jesusalbertomoraleslopez-byte/control-dimensional-calidad/sku_guide.png

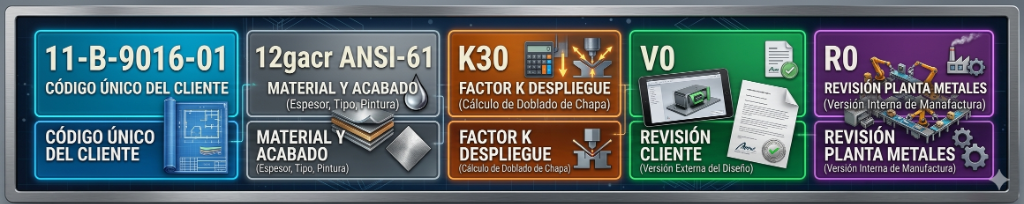
sku_guide.png
