jesusalbertomoraleslopez-byte/control-dimensional-calidad/README.md

# SIGRAMA METALES — Sistema Integral de Control Dimensional y Calidad 4.0

Sistema web industrial para gestión de calidad, diseño de ingeniería, control estadístico de procesos (SPC), inspección dimensional y visualización CAD 3D de piezas metálicas.

---

## 🚀 Versión: Mejoras de Visualización Septiembre 2026

Esta versión incorpora una renovación integral de la experiencia visual y operativa de la plataforma:

### 1. Centro de Control Principal (Cockpit 4.0)
- **Navegación Unificada:** Panel centralizado en 3 columnas ergonómicas (Pieza y Visor 3D | Opciones de Registro | Descargas).
- **Buscador en Tiempo Real:** Permite escribir y buscar cualquier número de pieza, SKU o consecutivo con auto-filtrado dinámico e inmediato.
- **Navegación Guiada:** Botones `◀ Ant.` y `Sig. ▶` que respetan los filtros de búsqueda activos.
- **Acceso Rápido Universal:** Botón de retorno "🔙 Volver a Página Principal" presente en todos los submódulos.

### 2. Visor CAD 3D Industrial
- **Pantalla Completa Optimizada:** Modo inmersivo para visualización e inspección de modelos 3D (STEP / CAD).
- **Barra de Herramientas Estilo SolidWorks / AutoCAD:** Botones con iconografía estándar para vistas ortogonales (Isométrica, Frontal, Superior, Lateral) y zoom fit.
- **Fondo Corporativo SIGRAMA:** Fondo integrado de alta fidelidad para el entorno 3D.
- **Captura al Portapapeles:** Botón directo para copiar la captura de pantalla extendida del visor 3D al portapapeles.

### 3. Centro de Descargas y Registro
- **Paquete Técnico Completo ZIP:** Compendio con planos de control, desplegados CNC (DXF), modelos 3D (STEP) y ficha técnica oficial autogenerada en PDF.
- **Historiales de Fabricación y Dimensionales:** Descarga directa de reportes y hojas de inspección.
- **Enlaces a Procesos Clave:** Acceso directo a PPVA (Aprobación de Planos), Primeras Piezas e Inspección en Piso (Órdenes de Fabricación).

---

## 🛠️ Tecnologías
- **Framework Web:** Streamlit
- **Motor 3D:** Three.js / OpenCascade (occt-import-js)
- **Almacenamiento Cloud:** Google Cloud Storage (GCS)
- **Base de Datos:** SQLite / JSON Seeds sincronizados
- **Generación de Reportes:** ReportLab (PDF), OpenPyXL, Python-docx

---
*Industria Sigrama S.A. de C.V. — Ingeniería que da resultados.*
