jesusalbertomoraleslopez-byte/control-dimensional-calidad/scratch/temp_design.xlsx

Sheet: CORTE
No. | RESP | DIM | LIM.I | LIM.S
1 | LASER | 19 | 18.985 | 19.015
2 | LASER | 3.527 | 3.512 | 3.542

Sheet: DOBLEZ
MEDIDA | DIMENSION | LIM.I | LIM.S
A | 0.63 | 0.615 | 0.645
B | 1.25 | 1.235 | 1.265
