jesusalbertomoraleslopez-byte/control-dimensional-calidad/sigrama_cad_bg.jpg

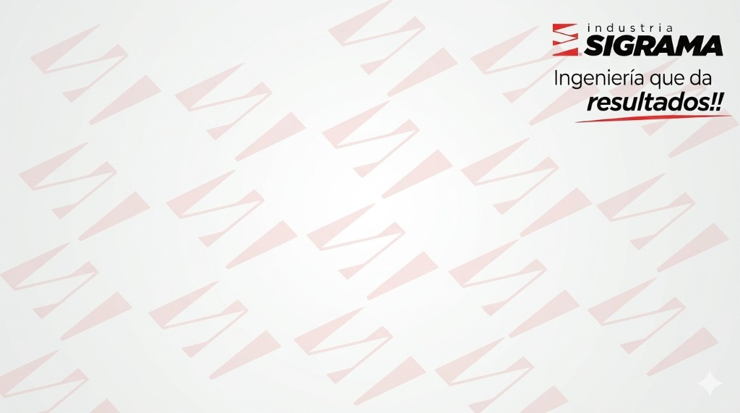
sigrama_cad_bg.jpg
