jesusalbertomoraleslopez-byte/control-dimensional-calidad/src/Proyectos/11-6463-01/Rev_R0/FactorK_61/Espesor_0.105/11-6463-01-(12gacr ANSI-61) - K61 - V6-R0.STEP

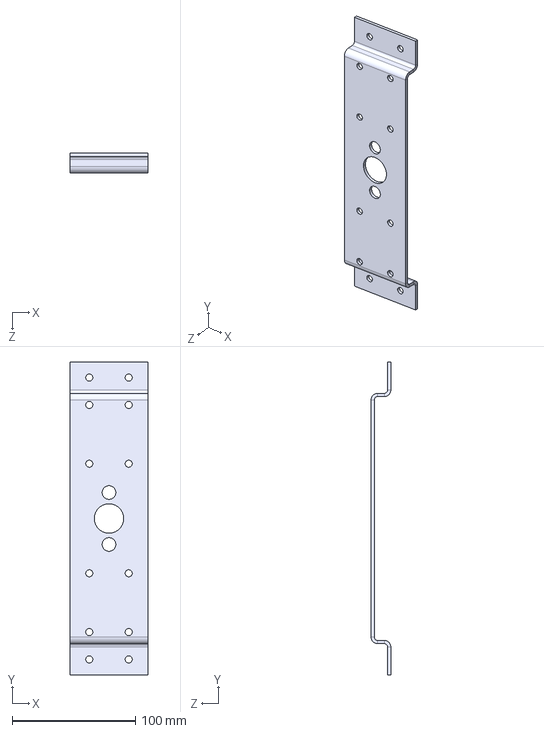
[picture p3: CAD file, 2026-09-10, last stored version]
src/Proyectos/11-6463-01/Rev_R0/FactorK_61/Espesor_0.105/11-6463-01-(12gacr ANSI-61) - K61 - V6-R0.STEP
63.5 x 254.0 x 16.0 mm
