jesusalbertomoraleslopez-byte/control-dimensional-calidad/src/Proyectos/11-8232-01/Rev_R0/FactorK_61/Espesor_0.105/11-8232-01-(12gacr ANSI-61) - K61 - V4-R0.STEP

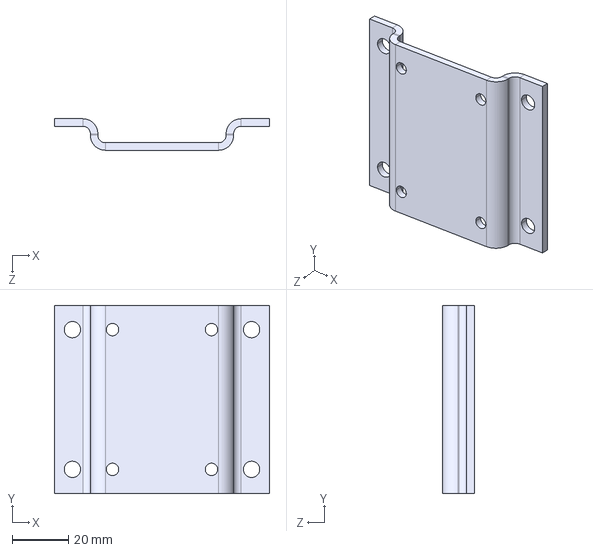
[picture p4: CAD file, 2026-09-10, last stored version]
src/Proyectos/11-8232-01/Rev_R0/FactorK_61/Espesor_0.105/11-8232-01-(12gacr ANSI-61) - K61 - V4-R0.STEP
76.2 x 66.8 x 11.2 mm
