jesusalbertomoraleslopez-byte/control-dimensional-calidad/src/Proyectos/11-A-6004-01/Rev_R0/FactorK_48/Espesor_0.060/11-A-6004-01-(16ga ANSI-61) - K48 - V3-R0.STEP

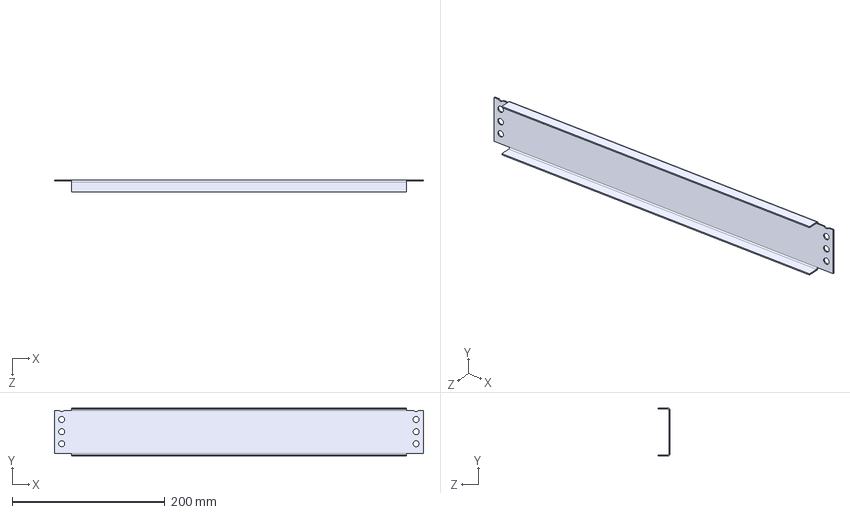
[picture p5: CAD file, 2026-09-10, last stored version]
src/Proyectos/11-A-6004-01/Rev_R0/FactorK_48/Espesor_0.060/11-A-6004-01-(16ga ANSI-61) - K48 - V3-R0.STEP
482.6 x 62.7 x 16.0 mm
