jesusalbertomoraleslopez-byte/control-dimensional-calidad/src/Proyectos/11-A-6014-01/Rev_R0/FactorK_48/Espesor_0.060/11-A-6014-01-(16ga ANSI-61) - K48 - V5-R0.STEP

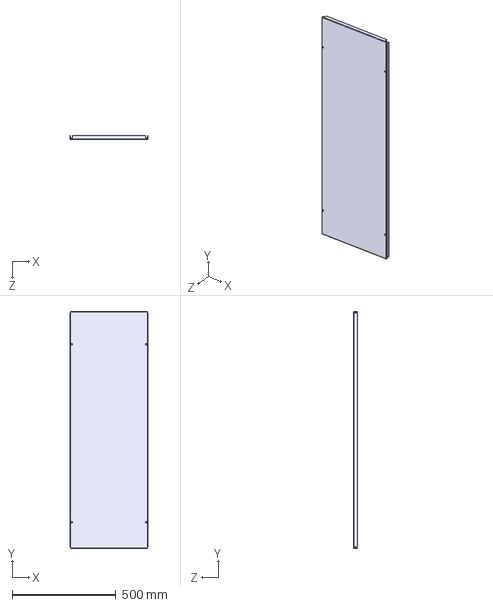
[picture p6: CAD file, 2026-09-10, last stored version]
src/Proyectos/11-A-6014-01/Rev_R0/FactorK_48/Espesor_0.060/11-A-6014-01-(16ga ANSI-61) - K48 - V5-R0.STEP
376.2 x 1141.5 x 19.1 mm
