jesusalbertomoraleslopez-byte/control-dimensional-calidad/src/Proyectos/11-A-6015-01/Rev_R0/FactorK_48/Espesor_0.060/11-A-6015-01-(16gacr ANSI-61) - K48 - V3-R0.STEP

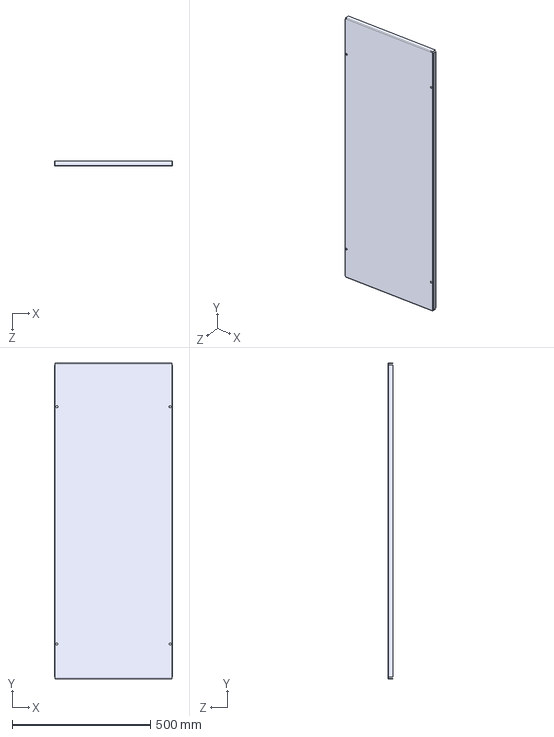
[picture p7: CAD file, 2026-09-10, last stored version]
src/Proyectos/11-A-6015-01/Rev_R0/FactorK_48/Espesor_0.060/11-A-6015-01-(16gacr ANSI-61) - K48 - V3-R0.STEP
427.0 x 1141.5 x 19.1 mm
