jesusalbertomoraleslopez-byte/control-dimensional-calidad/src/Proyectos/11-A-6016-01/Rev_R0/FactorK_48/Espesor_0.060/11-A-6016-01-(16gacr ANSI-61) - K48 - V5-R0.STEP

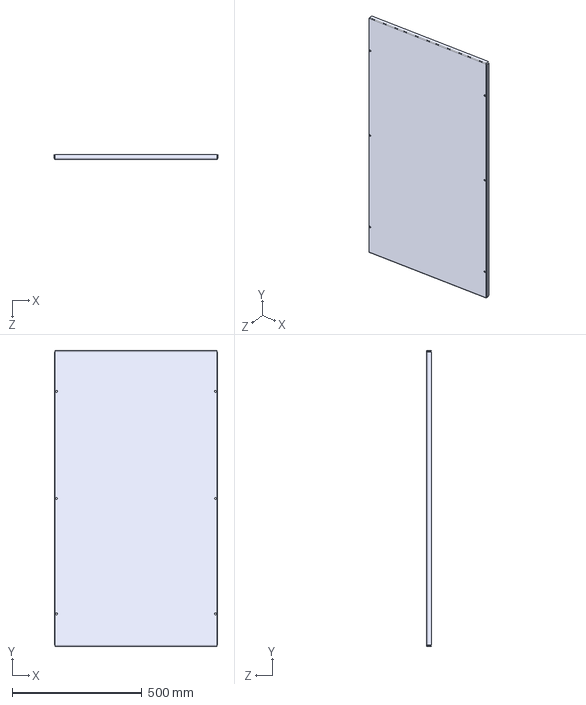
[picture p8: CAD file, 2026-09-10, last stored version]
src/Proyectos/11-A-6016-01/Rev_R0/FactorK_48/Espesor_0.060/11-A-6016-01-(16gacr ANSI-61) - K48 - V5-R0.STEP
630.2 x 1141.5 x 19.1 mm
