jesusalbertomoraleslopez-byte/control-dimensional-calidad/src/Proyectos/11-B-9016-01/Rev_R0/FactorK_30/Espesor_0.105/11-B-9016-01-(12gacr ANSI-61) - K30 - V0-R0.STEP

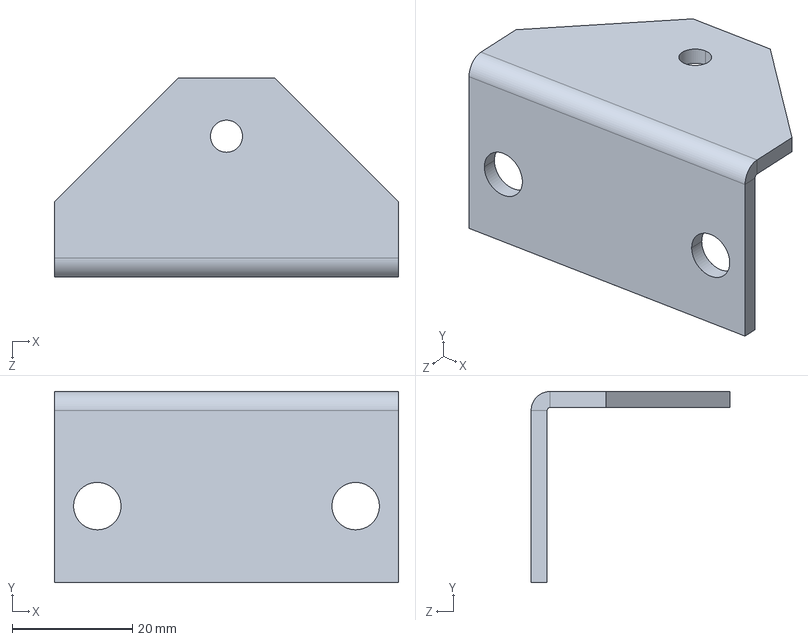
[picture p9: CAD file, 2026-06-26, last stored version]
src/Proyectos/11-B-9016-01/Rev_R0/FactorK_30/Espesor_0.105/11-B-9016-01-(12gacr ANSI-61) - K30 - V0-R0.STEP
57.1 x 31.8 x 33.0 mm
