jesusalbertomoraleslopez-byte/control-dimensional-calidad/src/Proyectos/11-D-3385-01/Rev_R0/FactorK_48/Espesor_0.060/11-D-3385-01-(16gacr ANSI-61) - K48 - V0-R0.STEP

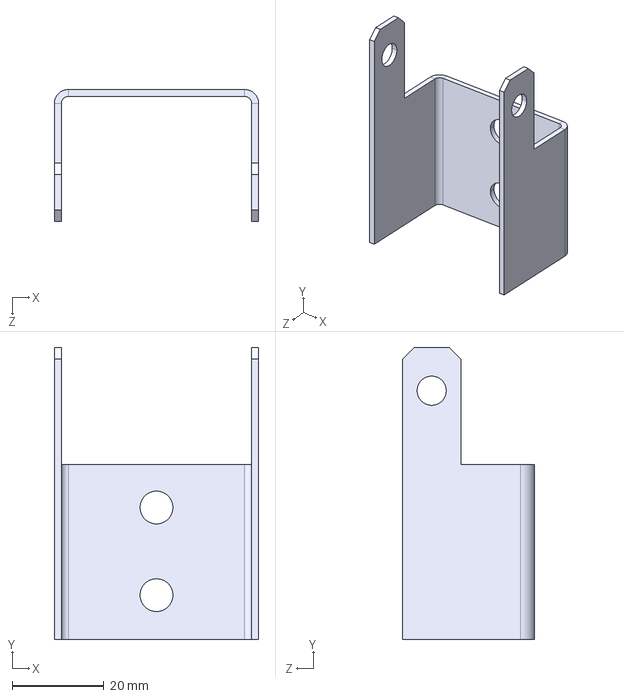
[picture p10: CAD file, 2026-09-10, last stored version]
src/Proyectos/11-D-3385-01/Rev_R0/FactorK_48/Espesor_0.060/11-D-3385-01-(16gacr ANSI-61) - K48 - V0-R0.STEP
44.5 x 63.5 x 28.7 mm
