jesusalbertomoraleslopez-byte/control-dimensional-calidad/src/Proyectos/11-D-3402-01/Rev_R0/FactorK_48/Espesor_0.060/11-D-3402-01-(16gacr ANSI-61) - K48 - V1-R0.STEP

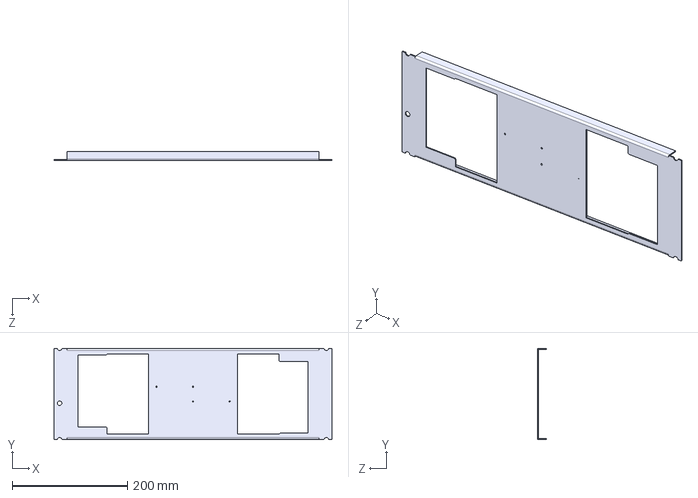
[picture p11: CAD file, 2026-09-10, last stored version]
src/Proyectos/11-D-3402-01/Rev_R0/FactorK_48/Espesor_0.060/11-D-3402-01-(16gacr ANSI-61) - K48 - V1-R0.STEP
482.6 x 158.0 x 16.0 mm
