jesusalbertomoraleslopez-byte/control-dimensional-calidad/src/Proyectos/11-D-3408-01/Rev_R0/FactorK_48/Espesor_0.060/11-D-3408-01-(16ga ANSI-61) - K48 - V0-R0.STEP

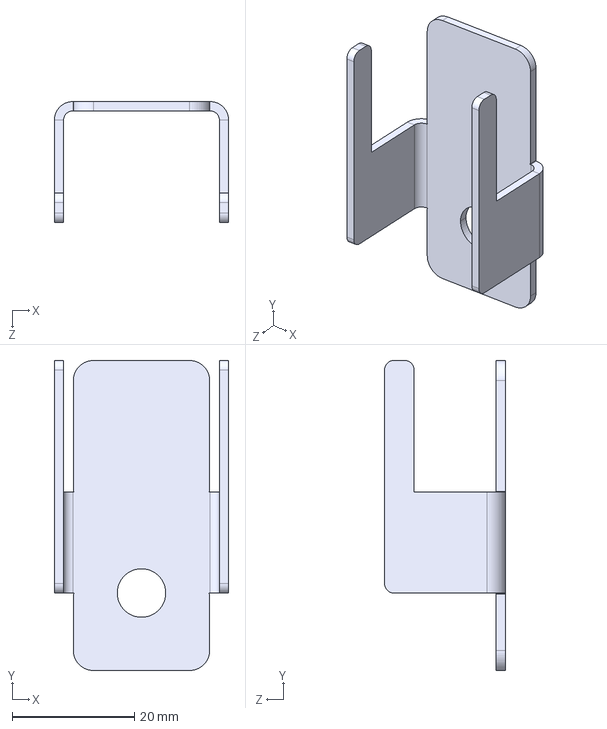
[picture p12: CAD file, 2026-09-10, last stored version]
src/Proyectos/11-D-3408-01/Rev_R0/FactorK_48/Espesor_0.060/11-D-3408-01-(16ga ANSI-61) - K48 - V0-R0.STEP
28.6 x 50.8 x 19.8 mm
