jesusalbertomoraleslopez-byte/control-dimensional-calidad/src/Proyectos/11-D-3409-01/Rev_R0/FactorK_48/Espesor_0.105/11-D-3409-01-(12gacr ANSI-61) - K48 - V1-R0.STEP

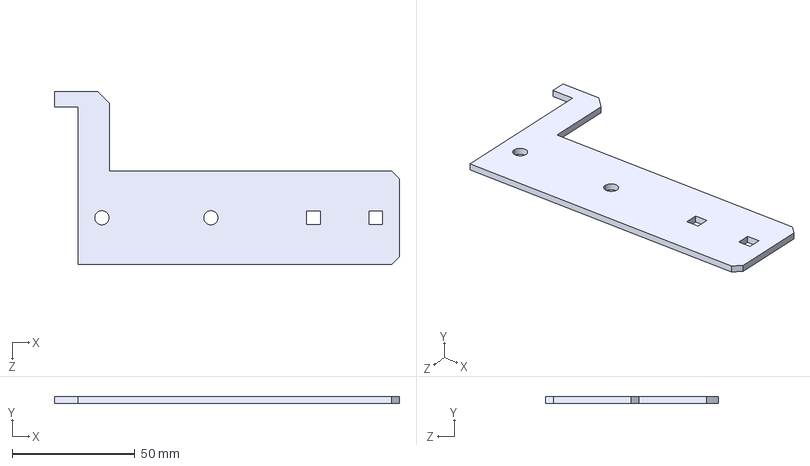
[picture p13: CAD file, 2026-09-10, last stored version]
src/Proyectos/11-D-3409-01/Rev_R0/FactorK_48/Espesor_0.105/11-D-3409-01-(12gacr ANSI-61) - K48 - V1-R0.STEP
140.6 x 2.67 x 70.5 mm
