jesusalbertomoraleslopez-byte/control-dimensional-calidad/src/Proyectos/12-6010-02/Rev_R0/FactorK_48/Espesor_0.060/12-6010-02-(16gacr ANSI-61) - K48 - V11-R0.STEP

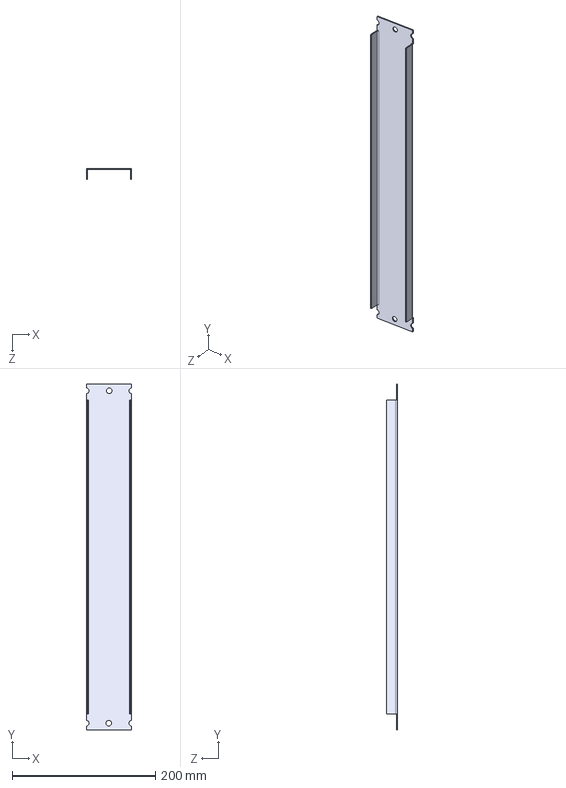
[picture p16: CAD file, 2026-09-10, last stored version]
src/Proyectos/12-6010-02/Rev_R0/FactorK_48/Espesor_0.060/12-6010-02-(16gacr ANSI-61) - K48 - V11-R0.STEP
62.7 x 482.6 x 16.0 mm
