jesusalbertomoraleslopez-byte/control-dimensional-calidad/src/Proyectos/12-6010-09/Rev_R0/FactorK_48/Espesor_0.060/12-6010-09-(16gacr ANSI-61) - K48 - V11-R0.STEP

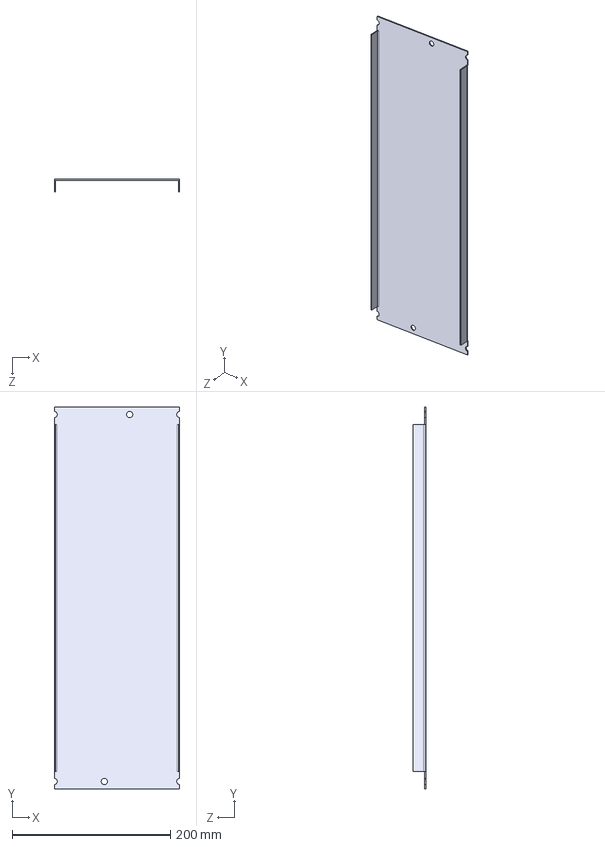
[picture p19: CAD file, 2026-09-10, last stored version]
src/Proyectos/12-6010-09/Rev_R0/FactorK_48/Espesor_0.060/12-6010-09-(16gacr ANSI-61) - K48 - V11-R0.STEP
158.0 x 482.6 x 16.0 mm
