jesusalbertomoraleslopez-byte/control-dimensional-calidad/src/Proyectos/12-6113-05/Rev_R2/FactorK_47/Espesor_0.105/12-6113-05-(12gacr ANSI-61) - K47 - V13-R2.STEP

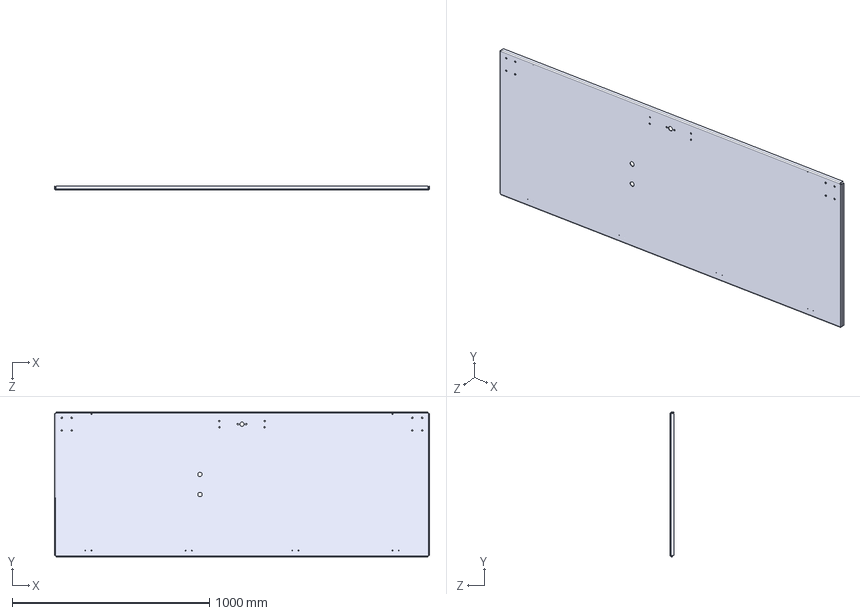
[picture p20: CAD file, 2026-09-10, last stored version]
src/Proyectos/12-6113-05/Rev_R2/FactorK_47/Espesor_0.105/12-6113-05-(12gacr ANSI-61) - K47 - V13-R2.STEP
1898.9 x 731.8 x 19.1 mm
