jesusalbertomoraleslopez-byte/control-dimensional-calidad/src/Proyectos/12-6355-02/Rev_R0/FactorK_48/Espesor_0.060/12-6355-02-(16ga ANSI-61) - K48 - V2-R0.STEP

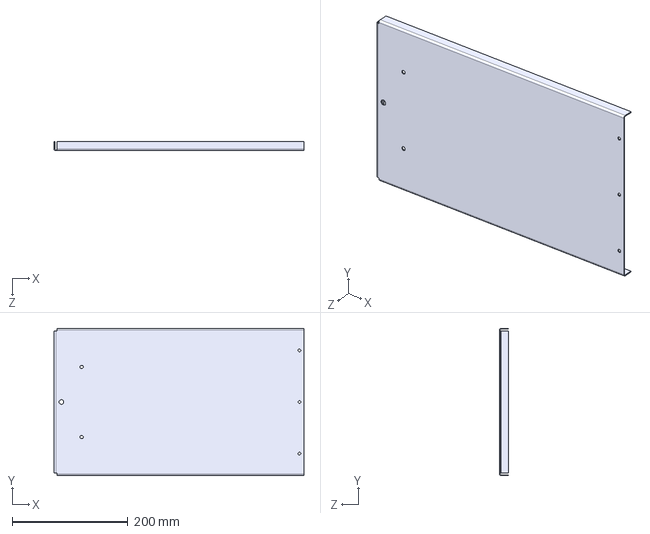
[picture p21: CAD file, 2026-09-10, last stored version]
src/Proyectos/12-6355-02/Rev_R0/FactorK_48/Espesor_0.060/12-6355-02-(16ga ANSI-61) - K48 - V2-R0.STEP
431.0 x 254.0 x 16.0 mm
