jesusalbertomoraleslopez-byte/control-dimensional-calidad/src/Proyectos/12-A-6199-01/Rev_R0/FactorK_48/Espesor_0.105/12-A-6199-01-(12gacr ANSI-61) - K48 - V3-R0.STEP

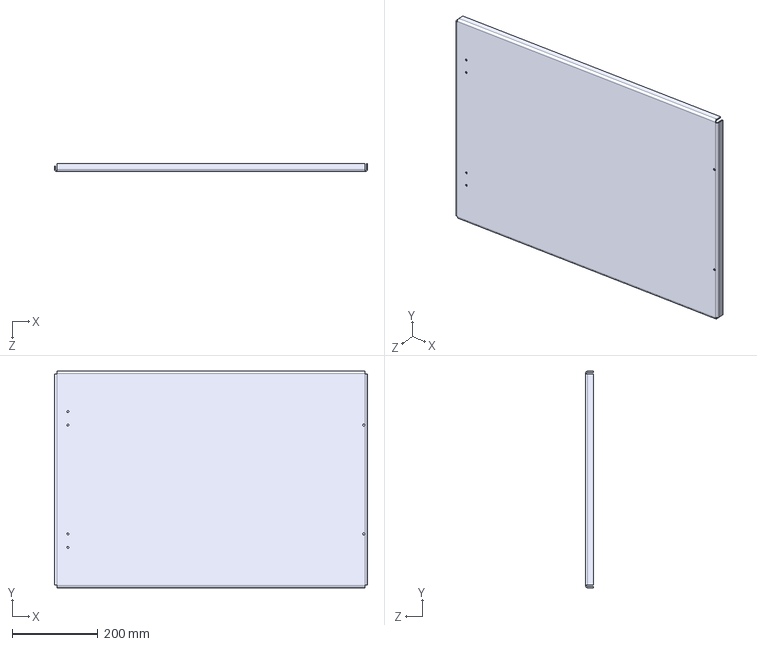
[picture p23: CAD file, 2026-09-10, last stored version]
src/Proyectos/12-A-6199-01/Rev_R0/FactorK_48/Espesor_0.105/12-A-6199-01-(12gacr ANSI-61) - K48 - V3-R0.STEP
731.8 x 506.5 x 19.1 mm
