jesusalbertomoraleslopez-byte/control-dimensional-calidad/src/Proyectos/12-A-6199-02/Rev_R2/FactorK_47/Espesor_0.105/12-A-6199-02-(12gacr ANSI-61) - K47 - V3-R2.STEP

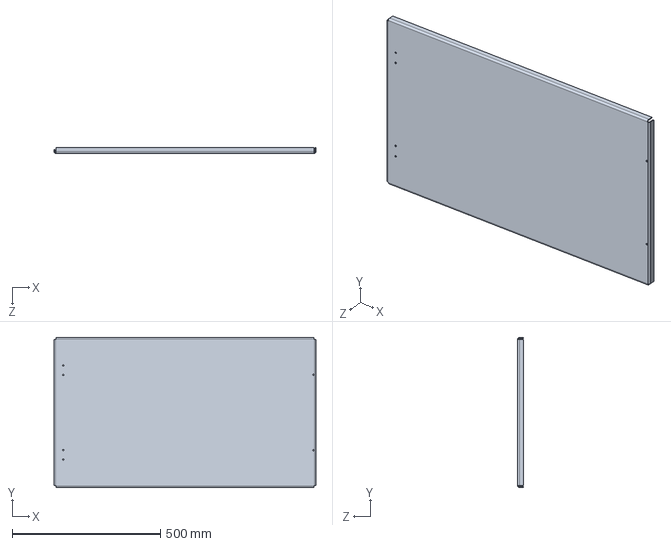
[picture p24: CAD file, 2026-06-26, last stored version]
src/Proyectos/12-A-6199-02/Rev_R2/FactorK_47/Espesor_0.105/12-A-6199-02-(12gacr ANSI-61) - K47 - V3-R2.STEP
884.2 x 506.5 x 19.1 mm
