jesusalbertomoraleslopez-byte/control-dimensional-calidad/src/Proyectos/12-A-6200-02/Rev_R2/FactorK_47/Espesor_0.105/12-A-6200-02-(12gacr ANSI-61) - K47 - V4-R2.STEP

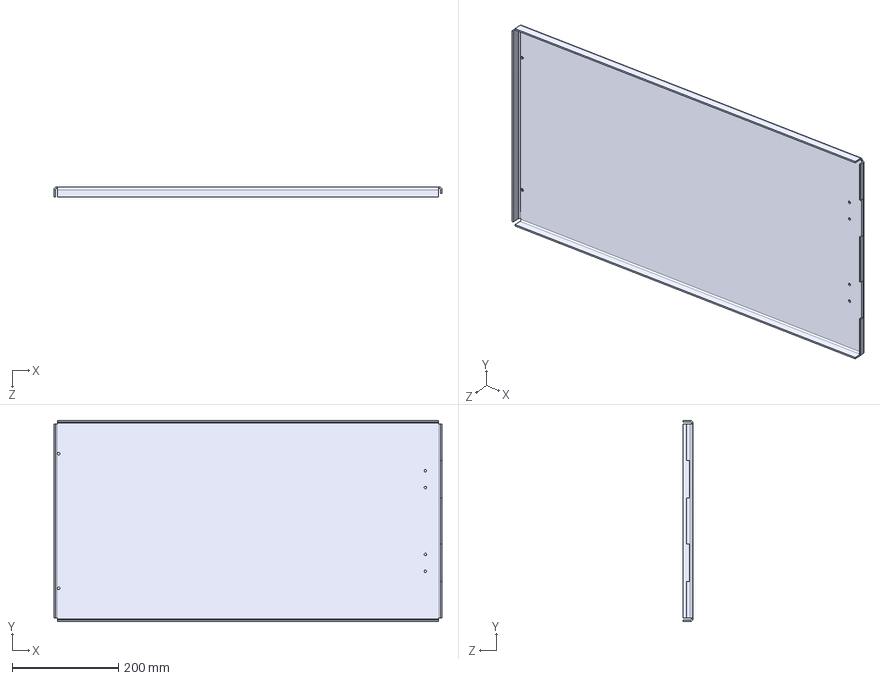
[picture p25: CAD file, 2026-09-10, last stored version]
src/Proyectos/12-A-6200-02/Rev_R2/FactorK_47/Espesor_0.105/12-A-6200-02-(12gacr ANSI-61) - K47 - V4-R2.STEP
731.8 x 379.5 x 19.1 mm
