jesusalbertomoraleslopez-byte/control-dimensional-calidad/src/Proyectos/12-A-6359-02/Rev_R3/FactorK_47/Espesor_0.105/12-A-6359-02-(12gacr ANSI-61) - K47 - V6-R3.STEP

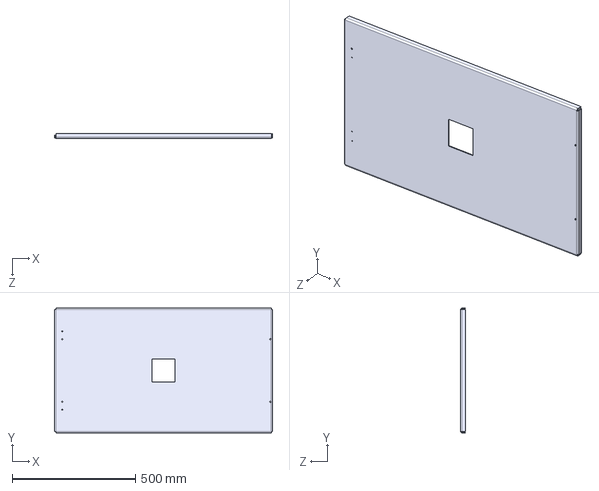
[picture p27: CAD file, 2026-09-10, last stored version]
src/Proyectos/12-A-6359-02/Rev_R3/FactorK_47/Espesor_0.105/12-A-6359-02-(12gacr ANSI-61) - K47 - V6-R3.STEP
884.2 x 506.5 x 19.1 mm
