jesusalbertomoraleslopez-byte/control-dimensional-calidad/src/Proyectos/12-C-6210-01/Rev_R0/FactorK_48/Espesor_0.060/12-C-6210-01-(16ga ANSI-61) - K48 - V0-R0.STEP

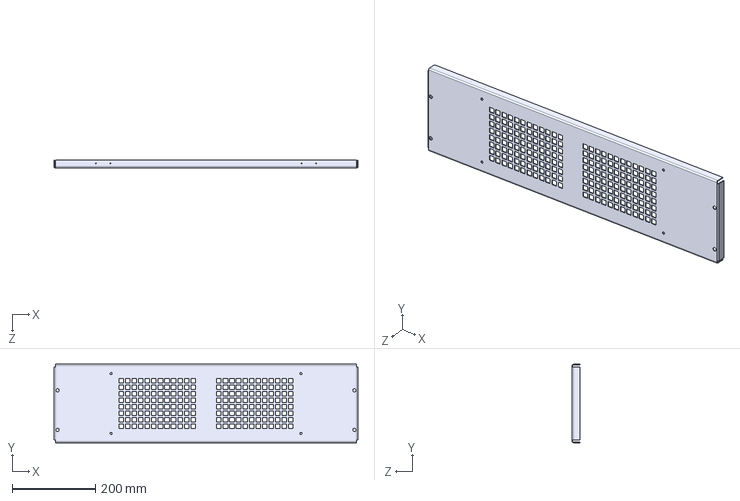
[picture p29: CAD file, 2026-09-10, last stored version]
src/Proyectos/12-C-6210-01/Rev_R0/FactorK_48/Espesor_0.060/12-C-6210-01-(16ga ANSI-61) - K48 - V0-R0.STEP
731.8 x 189.0 x 19.1 mm
