jesusalbertomoraleslopez-byte/control-dimensional-calidad/src/Proyectos/12-C-6210-02/Rev_R0/FactorK_48/Espesor_0.060/12-C-6210-02-(16ga ANSI-61) - K48 - V0-R0.STEP

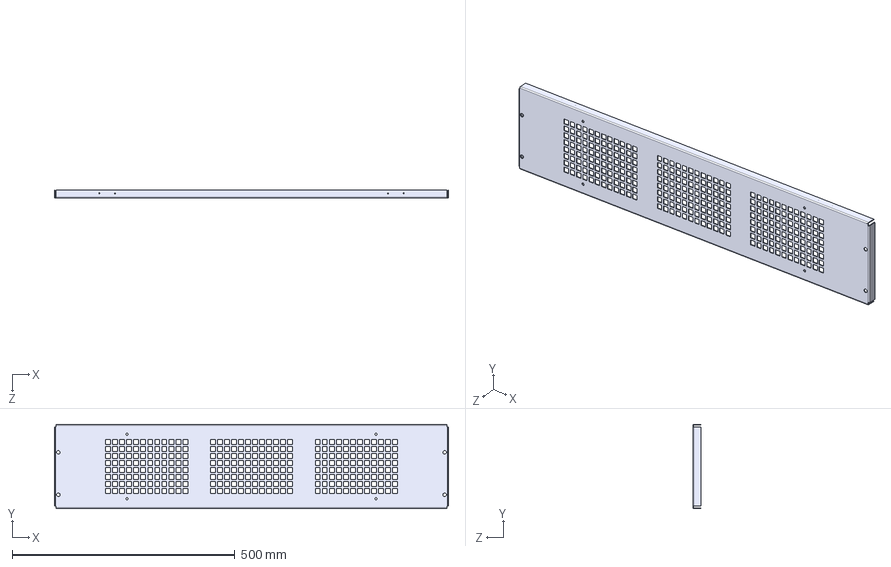
[picture p30: CAD file, 2026-09-10, last stored version]
src/Proyectos/12-C-6210-02/Rev_R0/FactorK_48/Espesor_0.060/12-C-6210-02-(16ga ANSI-61) - K48 - V0-R0.STEP
884.2 x 189.0 x 19.1 mm
