jesusalbertomoraleslopez-byte/control-dimensional-calidad/src/Proyectos/12-C-6211-08/Rev_R0/FactorK_48/Espesor_0.060/12-C-6211-08-(16gacr ANSI-61) - K48 - V0-R0.STEP

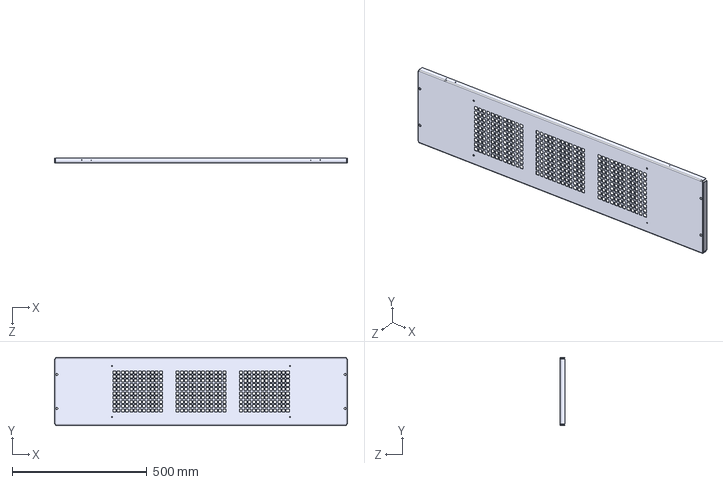
[picture p33: CAD file, 2026-09-10, last stored version]
src/Proyectos/12-C-6211-08/Rev_R0/FactorK_48/Espesor_0.060/12-C-6211-08-(16gacr ANSI-61) - K48 - V0-R0.STEP
1087.4 x 252.5 x 19.1 mm
