jesusalbertomoraleslopez-byte/control-dimensional-calidad/src/Proyectos/12-D-6033-05/Rev_R0/FactorK_48/Espesor_0.105/12-D-6033-05-(12gacr ANSI-61) - K48 - V2-R0.STEP

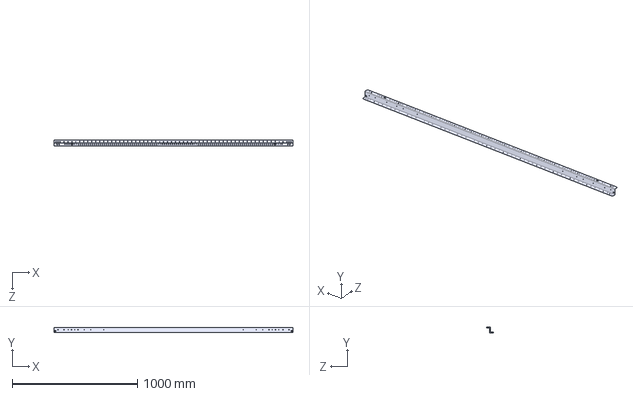
[picture p34: CAD file, 2026-09-10, last stored version]
src/Proyectos/12-D-6033-05/Rev_R0/FactorK_48/Espesor_0.105/12-D-6033-05-(12gacr ANSI-61) - K48 - V2-R0.STEP
1905.0 x 41.4 x 48.1 mm
