jesusalbertomoraleslopez-byte/control-dimensional-calidad/src/Proyectos/12-D-6080-06/Rev_R0/FactorK_48/Espesor_0.060/12-D-6080-06-(16ga ANSI-61) - K48 - V4-R0.STEP

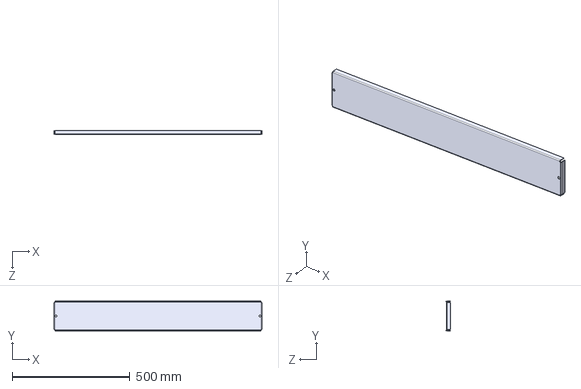
[picture p37: CAD file, 2026-09-10, last stored version]
src/Proyectos/12-D-6080-06/Rev_R0/FactorK_48/Espesor_0.060/12-D-6080-06-(16ga ANSI-61) - K48 - V4-R0.STEP
884.2 x 125.5 x 19.1 mm
