jesusalbertomoraleslopez-byte/control-dimensional-calidad/src/Proyectos/12-D-6082-05/Rev_R0/FactorK_48/Espesor_0.060/12-D-6082-05-(16ga ANSI-61) - K48 - V1-R0.STEP

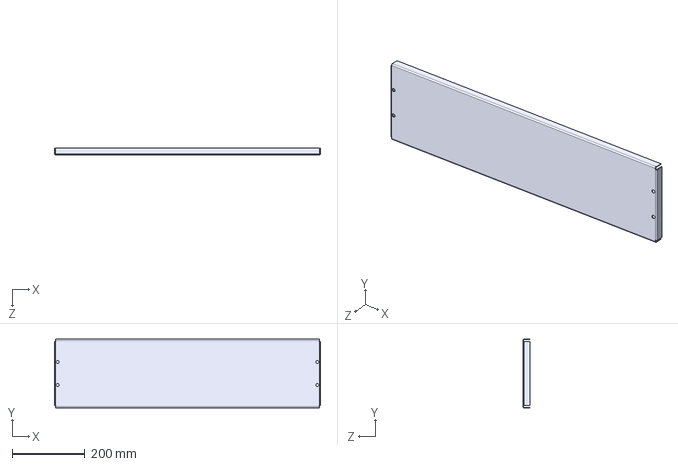
[picture p41: CAD file, 2026-09-10, last stored version]
src/Proyectos/12-D-6082-05/Rev_R0/FactorK_48/Espesor_0.060/12-D-6082-05-(16ga ANSI-61) - K48 - V1-R0.STEP
731.8 x 189.0 x 19.1 mm
