jesusalbertomoraleslopez-byte/control-dimensional-calidad/src/Proyectos/12-D-6089-01/Rev_R0/FactorK_48/Espesor_0.060/12-D-6089-01-(16gacr ANSI-61) - K48 - V0-R0.STEP

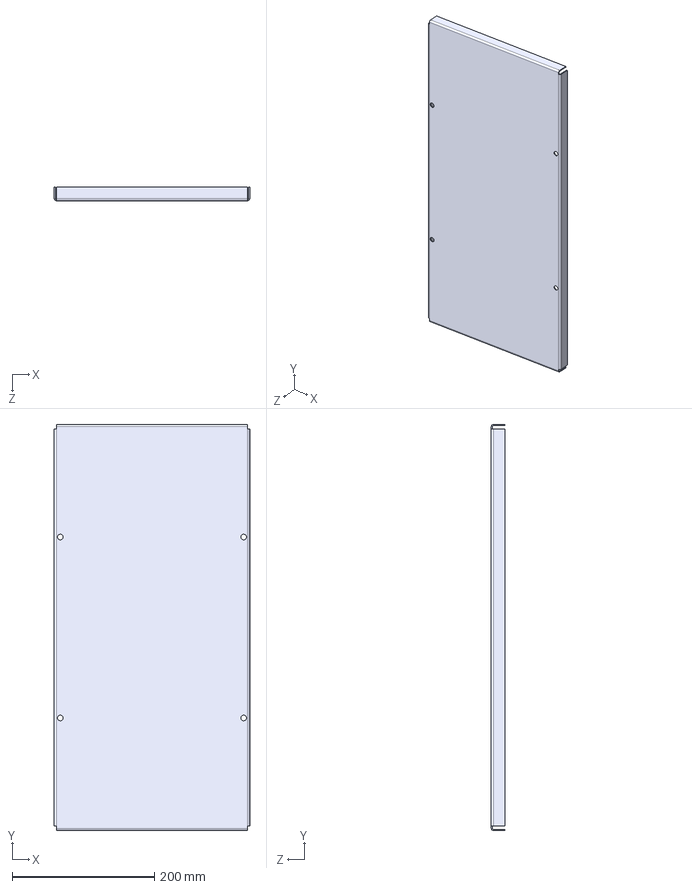
[picture p50: CAD file, 2026-09-10, last stored version]
src/Proyectos/12-D-6089-01/Rev_R0/FactorK_48/Espesor_0.060/12-D-6089-01-(16gacr ANSI-61) - K48 - V0-R0.STEP
274.6 x 570.0 x 19.1 mm
