jesusalbertomoraleslopez-byte/control-dimensional-calidad/src/Proyectos/12-D-6089-06/Rev_R0/FactorK_48/Espesor_0.060/12-D-6089-06-(16ga ANSI-61) - K48 - V0-R0.STEP

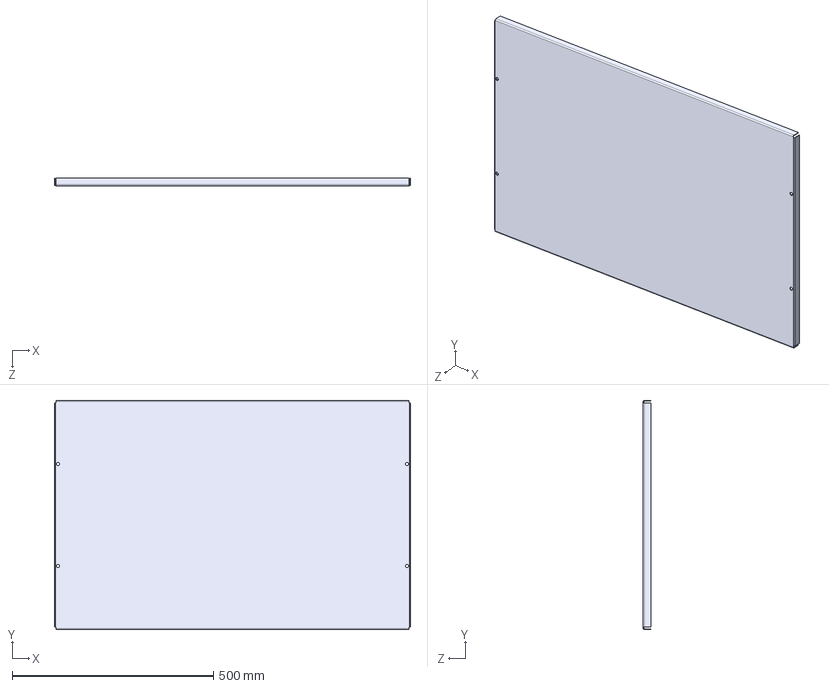
[picture p51: CAD file, 2026-09-10, last stored version]
src/Proyectos/12-D-6089-06/Rev_R0/FactorK_48/Espesor_0.060/12-D-6089-06-(16ga ANSI-61) - K48 - V0-R0.STEP
884.2 x 570.0 x 19.1 mm
