jesusalbertomoraleslopez-byte/control-dimensional-calidad/src/Proyectos/12-D-6091-01/Rev_R0/FactorK_48/Espesor_0.060/12-D-6091-01-(16gacr ANSI-61) - K48 - V1-R0.STEP

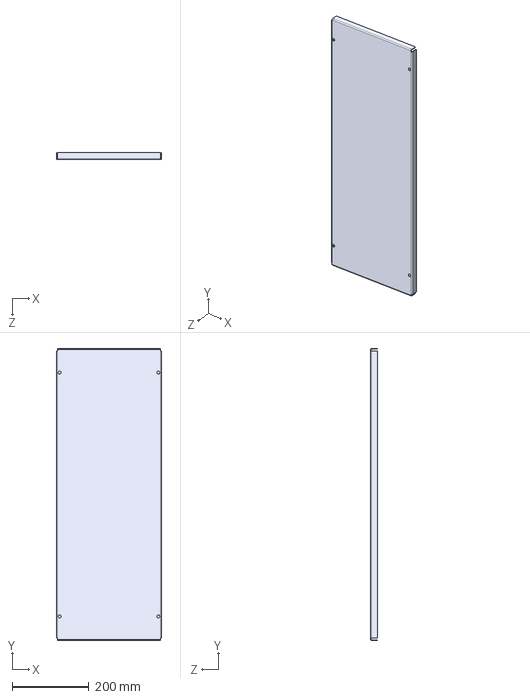
[picture p52: CAD file, 2026-09-10, last stored version]
src/Proyectos/12-D-6091-01/Rev_R0/FactorK_48/Espesor_0.060/12-D-6091-01-(16gacr ANSI-61) - K48 - V1-R0.STEP
274.6 x 760.5 x 19.1 mm
