jesusalbertomoraleslopez-byte/control-dimensional-calidad/src/Proyectos/12-D-6091-04/Rev_R0/FactorK_48/Espesor_0.060/12-D-6091-04-(16ga ANSI-61) - K48 - V1-R0.STEP

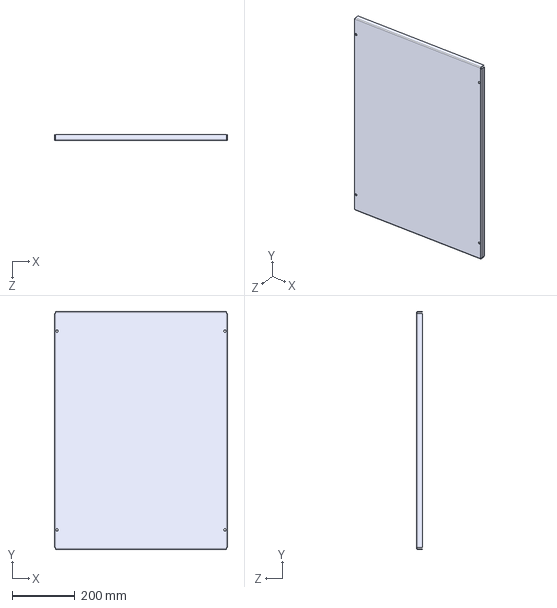
[picture p54: CAD file, 2026-09-10, last stored version]
src/Proyectos/12-D-6091-04/Rev_R0/FactorK_48/Espesor_0.060/12-D-6091-04-(16ga ANSI-61) - K48 - V1-R0.STEP
554.0 x 760.5 x 19.1 mm
