jesusalbertomoraleslopez-byte/control-dimensional-calidad/src/Proyectos/12-D-6099-13/Rev_R0/FactorK_48/Espesor_0.075/12-D-6099-13-(14gacr ANSI-61) - K48 - V1-R0.STEP

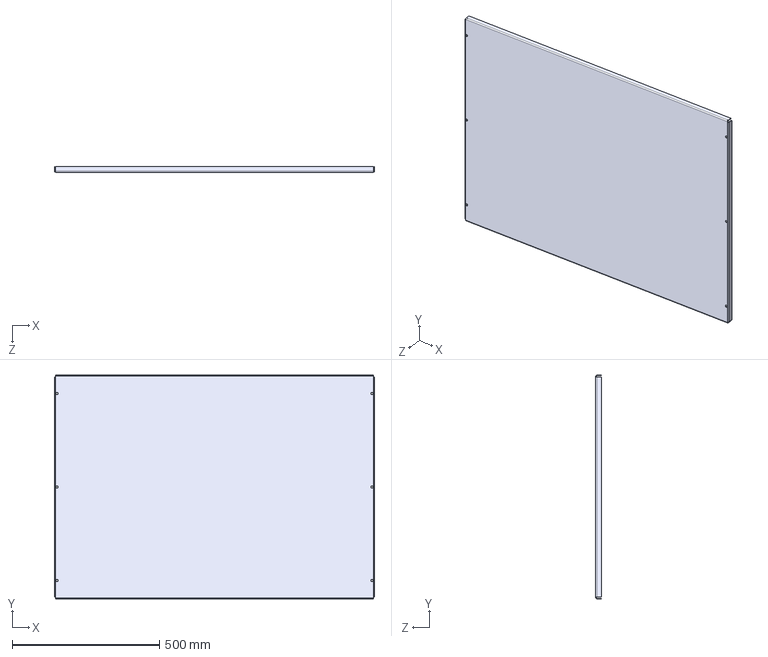
[picture p57: CAD file, 2026-09-10, last stored version]
src/Proyectos/12-D-6099-13/Rev_R0/FactorK_48/Espesor_0.075/12-D-6099-13-(14gacr ANSI-61) - K48 - V1-R0.STEP
1087.4 x 760.5 x 19.1 mm
