jesusalbertomoraleslopez-byte/control-dimensional-calidad/src/Proyectos/12-D-6106-06/Rev_R0/FactorK_48/Espesor_0.060/12-D-6106-06-(16gacr ANSI-61) - K48 - V7-R0.STEP

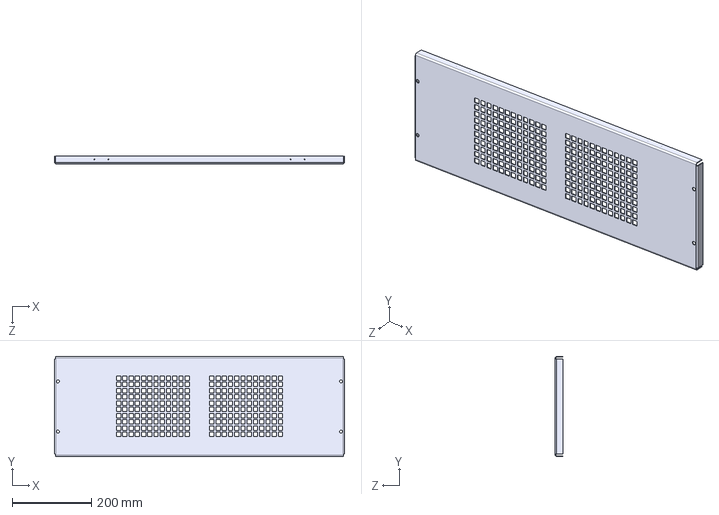
[picture p58: CAD file, 2026-09-10, last stored version]
src/Proyectos/12-D-6106-06/Rev_R0/FactorK_48/Espesor_0.060/12-D-6106-06-(16gacr ANSI-61) - K48 - V7-R0.STEP
731.8 x 252.5 x 19.1 mm
