jesusalbertomoraleslopez-byte/control-dimensional-calidad/src/Proyectos/12-D-6348-12/Rev_R0/FactorK_48/Espesor_0.060/12-D-6348-12-(16ga ANSI-61) - K48 - V12-R0.STEP

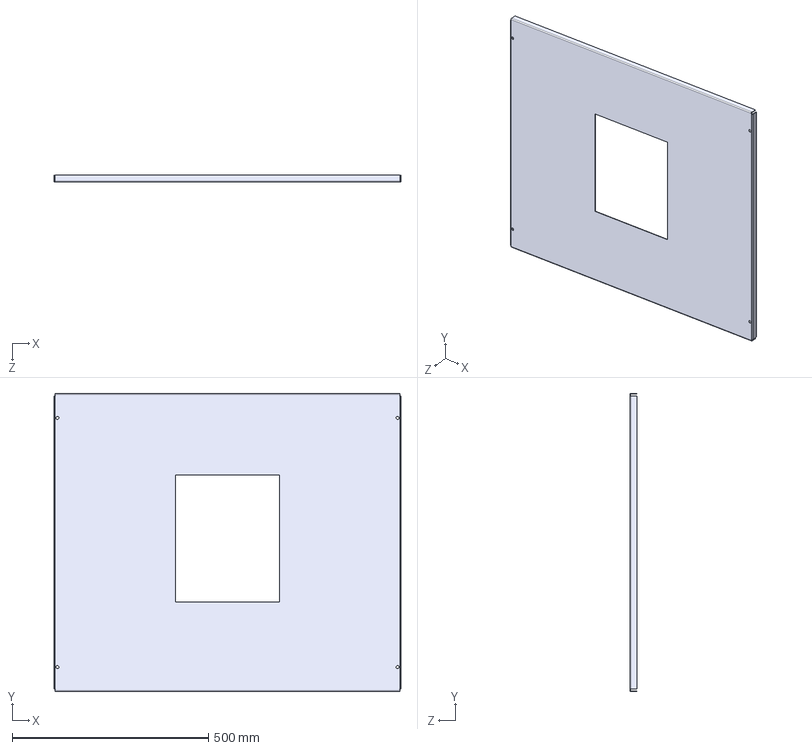
[picture p61: CAD file, 2026-09-10, last stored version]
src/Proyectos/12-D-6348-12/Rev_R0/FactorK_48/Espesor_0.060/12-D-6348-12-(16ga ANSI-61) - K48 - V12-R0.STEP
884.2 x 760.5 x 19.1 mm
