jesusalbertomoraleslopez-byte/control-dimensional-calidad/src/Proyectos/13-D-6328-01/Rev_R0/FactorK_48/Espesor_0.060/13-D-6328-01-(16gacr ANSI-61) - K48 - V0-R0.STEP

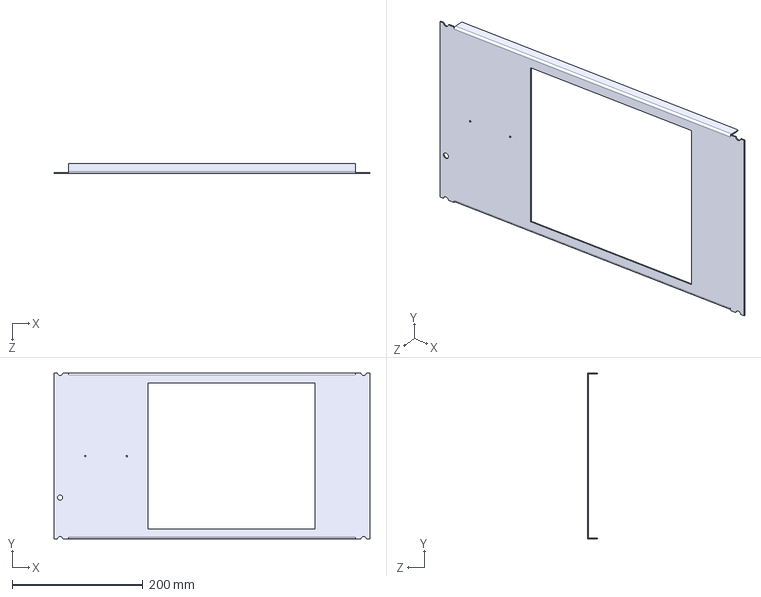
[picture p62: CAD file, 2026-09-10, last stored version]
src/Proyectos/13-D-6328-01/Rev_R0/FactorK_48/Espesor_0.060/13-D-6328-01-(16gacr ANSI-61) - K48 - V0-R0.STEP
482.6 x 253.2 x 16.0 mm
