jesusalbertomoraleslopez-byte/control-dimensional-calidad/src/Proyectos/16-6047-01/Rev_R0/FactorK_56/Espesor_0.105/16-6047-01-(12gacr ANSI-61) - K56 - V9-R0.STEP

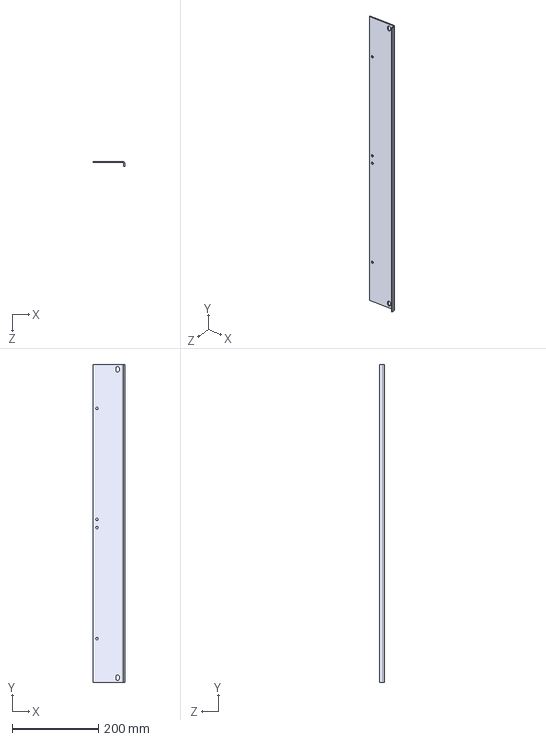
[picture p63: CAD file, 2026-09-10, last stored version]
src/Proyectos/16-6047-01/Rev_R0/FactorK_56/Espesor_0.105/16-6047-01-(12gacr ANSI-61) - K56 - V9-R0.STEP
73.2 x 736.6 x 12.7 mm
