jesusalbertomoraleslopez-byte/control-dimensional-calidad/src/Proyectos/16-6082-01/Rev_R0/FactorK_48/Espesor_0.060/16-6082-01-(16gacr ANSI-61) - K48 - V0-R0.STEP

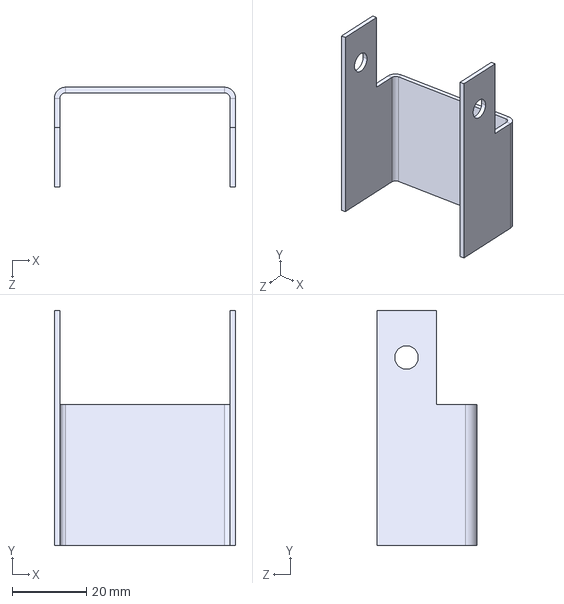
[picture p64: CAD file, 2026-09-10, last stored version]
src/Proyectos/16-6082-01/Rev_R0/FactorK_48/Espesor_0.060/16-6082-01-(16gacr ANSI-61) - K48 - V0-R0.STEP
49.0 x 63.5 x 26.9 mm
