jesusalbertomoraleslopez-byte/control-dimensional-calidad/src/Proyectos/17-D-6007-01/Rev_R0/FactorK_48/Espesor_0.060/17-D-6007-01-(16ga ANSI-61) - K48 - V1-R0.STEP

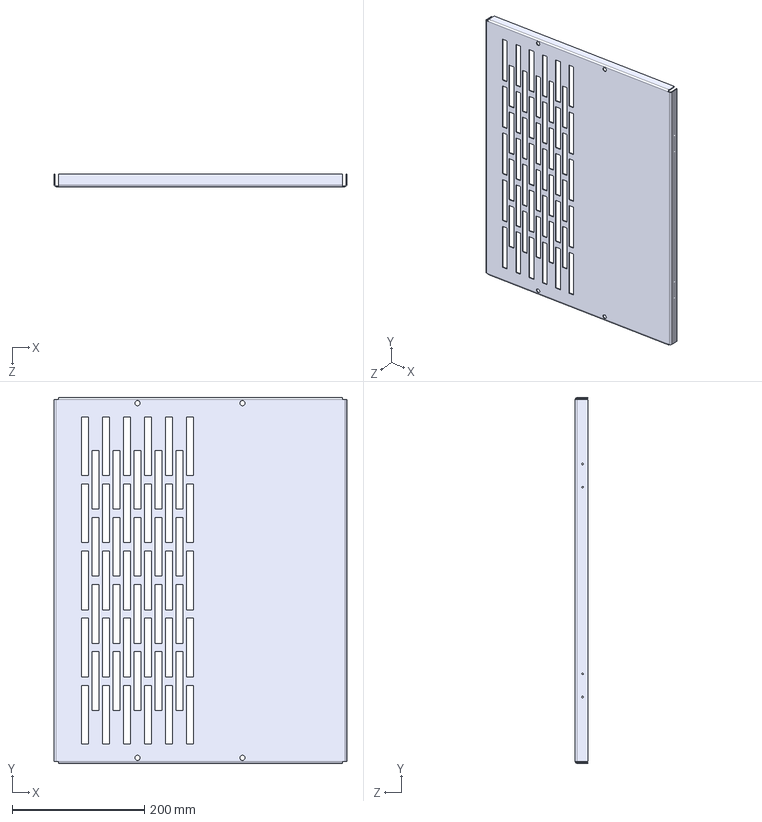
[picture p66: CAD file, 2026-09-10, last stored version]
src/Proyectos/17-D-6007-01/Rev_R0/FactorK_48/Espesor_0.060/17-D-6007-01-(16ga ANSI-61) - K48 - V1-R0.STEP
443.0 x 554.0 x 19.1 mm
