jesusalbertomoraleslopez-byte/control-dimensional-calidad/src/Proyectos/17-D-6007-02/Rev_R0/FactorK_48/Espesor_0.060/17-D-6007-02-(16ga ANSI-61) - K48 - V1-R0.STEP

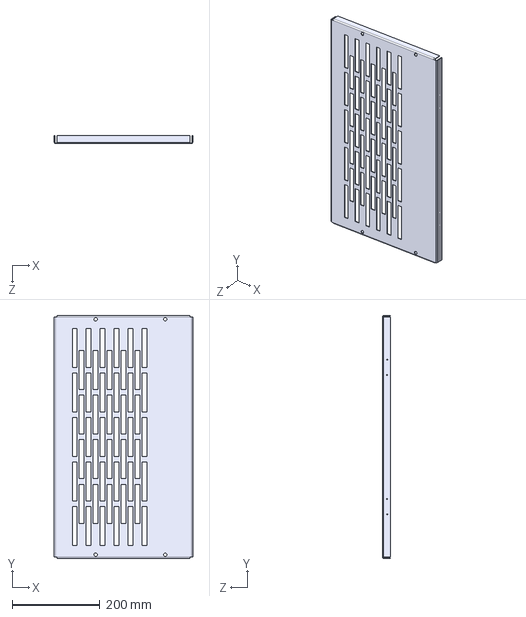
[picture p67: CAD file, 2026-09-10, last stored version]
src/Proyectos/17-D-6007-02/Rev_R0/FactorK_48/Espesor_0.060/17-D-6007-02-(16ga ANSI-61) - K48 - V1-R0.STEP
316.0 x 554.0 x 19.1 mm
