jesusalbertomoraleslopez-byte/control-dimensional-calidad/src/Proyectos/17-D-6025-04/Rev_R0/FactorK_48/Espesor_0.060/17-D-6025-04-(16ga ANSI-61) - K48 - V0-R0.STEP

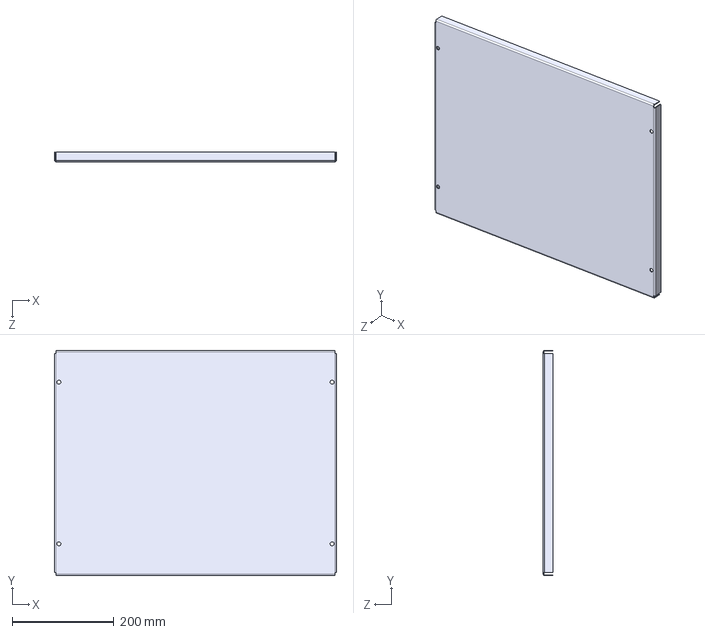
[picture p68: CAD file, 2026-09-10, last stored version]
src/Proyectos/17-D-6025-04/Rev_R0/FactorK_48/Espesor_0.060/17-D-6025-04-(16ga ANSI-61) - K48 - V0-R0.STEP
554.0 x 443.0 x 19.1 mm
