jesusalbertomoraleslopez-byte/control-dimensional-calidad/src/Proyectos/17-D-6047-01/Rev_R0/FactorK_0/Espesor_0.060/17-D-6047-01-(16gacr ANSI-61) - K0 - V1-R0.STEP

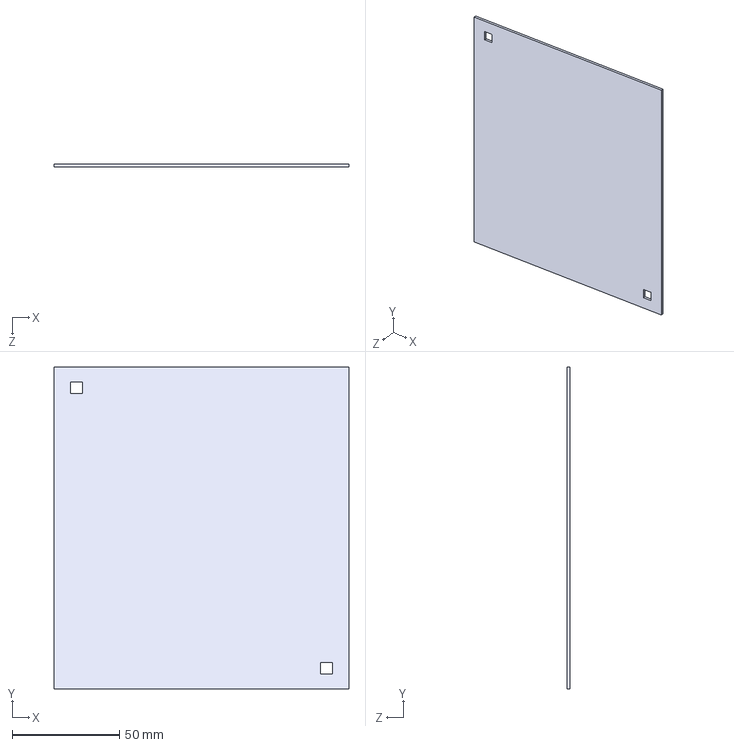
[picture p70: CAD file, 2026-09-10, last stored version]
src/Proyectos/17-D-6047-01/Rev_R0/FactorK_0/Espesor_0.060/17-D-6047-01-(16gacr ANSI-61) - K0 - V1-R0.STEP
137.2 x 149.9 x 1.52 mm
