jesusalbertomoraleslopez-byte/control-dimensional-calidad/src/Proyectos/PP1510-02/Rev_R0/FactorK_48/Espesor_0.060/PP1510-02-(16gacr ANSI-61) - K48 - V5-R0.STEP

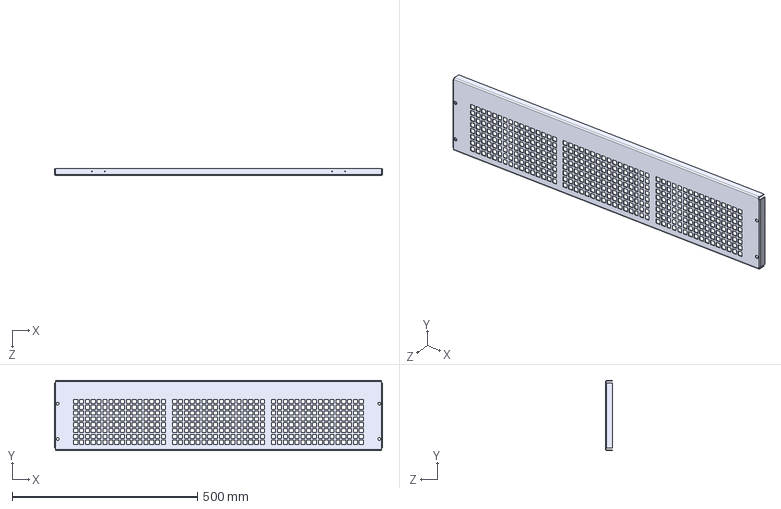
[picture p71: CAD file, 2026-09-10, last stored version]
src/Proyectos/PP1510-02/Rev_R0/FactorK_48/Espesor_0.060/PP1510-02-(16gacr ANSI-61) - K48 - V5-R0.STEP
884.2 x 189.0 x 19.1 mm
