jesusalbertomoraleslopez-byte/control-dimensional-calidad/src/Proyectos/PP8655/Rev_R0/FactorK_48/Espesor_0.105/PP8655-(12gacr ANSI-61) - K48 - V1-R0.STEP

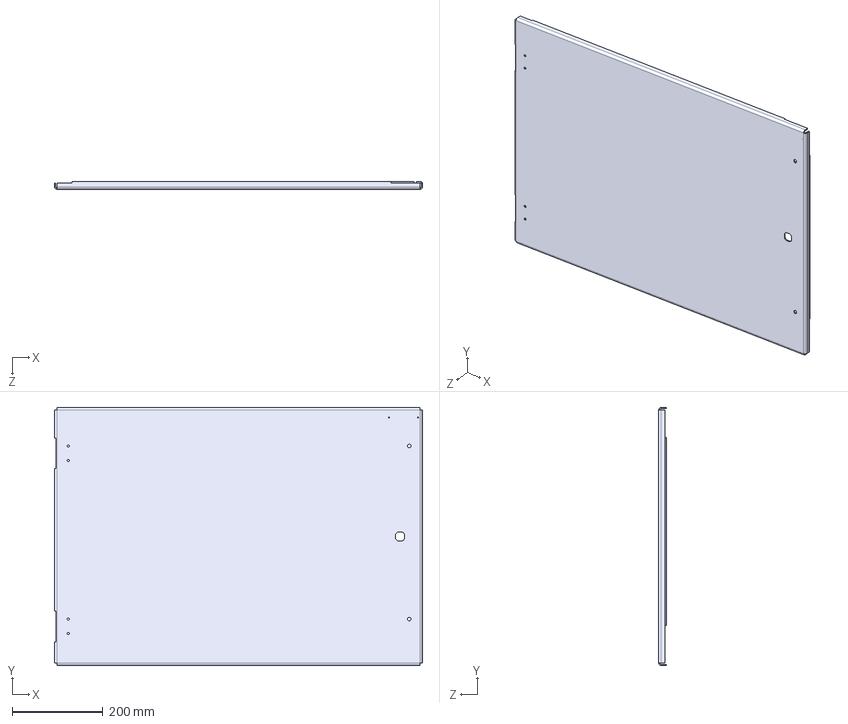
[picture p72: CAD file, 2026-09-10, last stored version]
src/Proyectos/PP8655/Rev_R0/FactorK_48/Espesor_0.105/PP8655-(12gacr ANSI-61) - K48 - V1-R0.STEP
809.6 x 568.5 x 16.7 mm
