jesusalbertomoraleslopez-byte/control-dimensional-calidad/src/Proyectos/PP9247/Rev_R0/FactorK_48/Espesor_0.075/PP9247-(14gacr ANSI-61) - K48 - V1-R0.STEP

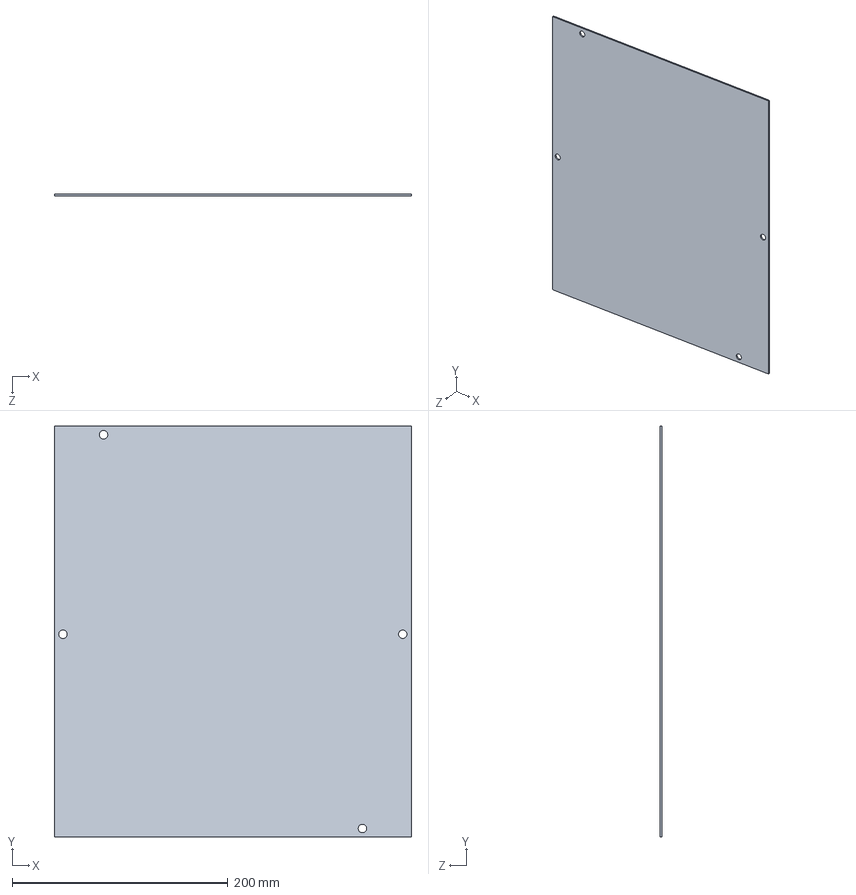
[picture p73: CAD file, 2026-06-26, last stored version]
src/Proyectos/PP9247/Rev_R0/FactorK_48/Espesor_0.075/PP9247-(14gacr ANSI-61) - K48 - V1-R0.STEP
331.0 x 381.0 x 1.90 mm
