jesusalbertomoraleslopez-byte/control-dimensional-calidad/(list of files, cad)

Other CAD files:
src/Proyectos/12-D-6047-03/Rev_R0/FactorK_48/Espesor_0.060/12-D-6047-03-(16ga ANSI-61) - K48 - V4-R0.STEP
src/Proyectos/12-D-6106-07/Rev_R0/FactorK_48/Espesor_0.060/12-D-6106-07-(16ga ANSI-61) - K48 - V7-R0.STEP
src/Proyectos/12-D-6106-08/Rev_R0/FactorK_48/Espesor_0.060/12-D-6106-08-(16ga ANSI-61) - K48 - V7-R0.STEP
src/Proyectos/17-D-6004-02/Rev_R0/FactorK_48/Espesor_0.060/17-D-6004-02-(16ga ANSI-61) - K48 - V2-R0.STEP
src/Proyectos/P6298-051/Rev_R0/FactorK_48/Espesor_0.060/P6298-051-(16ga ANSI-61) - K48 - V1-R0.STEP
src/Proyectos/PP7517-10/Rev_R0/FactorK_48/Espesor_0.060/PP7517-10-(16ga ANSI-61) - K48 - V1-R0.STEP
src/Proyectos/11-6463-01/Rev_R0/FactorK_61/Espesor_0.105/11-6463-01-(12gacr ANSI-61) - K61 - V6-R0.DXF
src/Proyectos/11-6463-01/Rev_R0/FactorK_61/Espesor_0.105/11-6463-01-(12gacr ANSI-61) - K61 - V6-R0.SLDDRW
src/Proyectos/11-6463-01/Rev_R0/FactorK_61/Espesor_0.105/11-6463-01-(12gacr ANSI-61) - K61 - V6-R0.SLDPRT
src/Proyectos/11-8232-01/Rev_R0/FactorK_61/Espesor_0.105/11-8232-01-(12gacr ANSI-61) - K61 - V4-R0.DXF
src/Proyectos/11-8232-01/Rev_R0/FactorK_61/Espesor_0.105/11-8232-01-(12gacr ANSI-61) - K61 - V4-R0.SLDDRW
src/Proyectos/11-8232-01/Rev_R0/FactorK_61/Espesor_0.105/11-8232-01-(12gacr ANSI-61) - K61 - V4-R0.SLDPRT
src/Proyectos/11-A-6004-01/Rev_R0/FactorK_48/Espesor_0.060/11-A-6004-01-(16ga ANSI-61) - K48 - V3-R0.DXF
src/Proyectos/11-A-6004-01/Rev_R0/FactorK_48/Espesor_0.060/11-A-6004-01-(16ga ANSI-61) - K48 - V3-R0.SLDDRW
src/Proyectos/11-A-6004-01/Rev_R0/FactorK_48/Espesor_0.060/11-A-6004-01-(16ga ANSI-61) - K48 - V3-R0.SLDPRT
src/Proyectos/11-A-6014-01/Rev_R0/FactorK_48/Espesor_0.060/11-A-6014-01-(16ga ANSI-61) - K48 - V5-R0.DXF
src/Proyectos/11-A-6014-01/Rev_R0/FactorK_48/Espesor_0.060/11-A-6014-01-(16ga ANSI-61) - K48 - V5-R0.SLDDRW
src/Proyectos/11-A-6014-01/Rev_R0/FactorK_48/Espesor_0.060/11-A-6014-01-(16ga ANSI-61) - K48 - V5-R0.SLDPRT
src/Proyectos/11-A-6015-01/Rev_R0/FactorK_48/Espesor_0.060/11-A-6015-01-(16gacr ANSI-61) - K48 - V3-R0.DXF
src/Proyectos/11-A-6015-01/Rev_R0/FactorK_48/Espesor_0.060/11-A-6015-01-(16gacr ANSI-61) - K48 - V3-R0.SLDDRW
src/Proyectos/11-A-6015-01/Rev_R0/FactorK_48/Espesor_0.060/11-A-6015-01-(16gacr ANSI-61) - K48 - V3-R0.SLDPRT
src/Proyectos/11-A-6016-01/Rev_R0/FactorK_48/Espesor_0.060/11-A-6016-01-(16gacr ANSI-61) - K48 - V5-R0.DXF
src/Proyectos/11-A-6016-01/Rev_R0/FactorK_48/Espesor_0.060/11-A-6016-01-(16gacr ANSI-61) - K48 - V5-R0.SLDDRW
src/Proyectos/11-A-6016-01/Rev_R0/FactorK_48/Espesor_0.060/11-A-6016-01-(16gacr ANSI-61) - K48 - V5-R0.SLDPRT
src/Proyectos/11-B-9016-01/Rev_R0/FactorK_30/Espesor_0.105/11-B-9016-01-(12gacr ANSI-61) - K30 - V0-R0.DXF
src/Proyectos/11-B-9016-01/Rev_R0/FactorK_30/Espesor_0.105/11-B-9016-01-(12gacr ANSI-61) - K30 - V0-R0.SLDDRW
src/Proyectos/11-B-9016-01/Rev_R0/FactorK_30/Espesor_0.105/11-B-9016-01-(12gacr ANSI-61) - K30 - V0-R0.SLDPRT
src/Proyectos/11-D-3385-01/Rev_R0/FactorK_48/Espesor_0.060/11-D-3385-01-(16gacr ANSI-61) - K48 - V0-R0.DXF
src/Proyectos/11-D-3385-01/Rev_R0/FactorK_48/Espesor_0.060/11-D-3385-01-(16gacr ANSI-61) - K48 - V0-R0.SLDDRW
src/Proyectos/11-D-3385-01/Rev_R0/FactorK_48/Espesor_0.060/11-D-3385-01-(16gacr ANSI-61) - K48 - V0-R0.SLDPRT
src/Proyectos/11-D-3402-01/Rev_R0/FactorK_48/Espesor_0.060/11-D-3402-01-(16gacr ANSI-61) - K48 - V1-R0.DXF
src/Proyectos/11-D-3402-01/Rev_R0/FactorK_48/Espesor_0.060/11-D-3402-01-(16gacr ANSI-61) - K48 - V1-R0.SLDDRW
src/Proyectos/11-D-3402-01/Rev_R0/FactorK_48/Espesor_0.060/11-D-3402-01-(16gacr ANSI-61) - K48 - V1-R0.SLDPRT
src/Proyectos/11-D-3408-01/Rev_R0/FactorK_48/Espesor_0.060/11-D-3408-01-(16ga ANSI-61) - K48 - V0-R0.DXF
src/Proyectos/11-D-3408-01/Rev_R0/FactorK_48/Espesor_0.060/11-D-3408-01-(16ga ANSI-61) - K48 - V0-R0.SLDDRW
src/Proyectos/11-D-3408-01/Rev_R0/FactorK_48/Espesor_0.060/11-D-3408-01-(16ga ANSI-61) - K48 - V0-R0.SLDPRT
src/Proyectos/11-D-3409-01/Rev_R0/FactorK_48/Espesor_0.105/11-D-3409-01-(12gacr ANSI-61) - K48 - V1-R0.DXF
src/Proyectos/11-D-3409-01/Rev_R0/FactorK_48/Espesor_0.105/11-D-3409-01-(12gacr ANSI-61) - K48 - V1-R0.SLDDRW
src/Proyectos/11-D-3409-01/Rev_R0/FactorK_48/Espesor_0.105/11-D-3409-01-(12gacr ANSI-61) - K48 - V1-R0.sldprt
src/Proyectos/11-D-6192-01/Rev_R0/FactorK_48/Espesor_0.060/11-D-6192-01-(16gacr ANSI-61) - K48 - V1-R0.DXF
src/Proyectos/11-D-6192-01/Rev_R0/FactorK_48/Espesor_0.060/11-D-6192-01-(16gacr ANSI-61) - K48 - V1-R0.SLDDRW
src/Proyectos/11-D-6192-01/Rev_R0/FactorK_48/Espesor_0.060/11-D-6192-01-(16gacr ANSI-61) - K48 - V1-R0.SLDPRT
src/Proyectos/12-6010-01/Rev_R0/FactorK_48/Espesor_0.060/12-6010-01-(16ga ANSI-61) - K48 - V11-R0.DXF
src/Proyectos/12-6010-01/Rev_R0/FactorK_48/Espesor_0.060/12-6010-01-(16ga ANSI-61) - K48 - V11-R0.SLDDRW
src/Proyectos/12-6010-01/Rev_R0/FactorK_48/Espesor_0.060/12-6010-01-(16ga ANSI-61) - K48 - V11-R0.SLDPRT
src/Proyectos/12-6010-02/Rev_R0/FactorK_48/Espesor_0.060/12-6010-02-(16gacr ANSI-61) - K48 - V11-R0.DXF
src/Proyectos/12-6010-02/Rev_R0/FactorK_48/Espesor_0.060/12-6010-02-(16gacr ANSI-61) - K48 - V11-R0.SLDDRW
src/Proyectos/12-6010-02/Rev_R0/FactorK_48/Espesor_0.060/12-6010-02-(16gacr ANSI-61) - K48 - V11-R0.SLDPRT
src/Proyectos/12-6010-03/Rev_R0/FactorK_48/Espesor_0.060/12-6010-03-(16ga ANSI-61) - K48 - V11-R0.DXF
src/Proyectos/12-6010-03/Rev_R0/FactorK_48/Espesor_0.060/12-6010-03-(16ga ANSI-61) - K48 - V11-R0.SLDDRW
src/Proyectos/12-6010-03/Rev_R0/FactorK_48/Espesor_0.060/12-6010-03-(16ga ANSI-61) - K48 - V11-R0.SLDPRT
src/Proyectos/12-6010-04/Rev_R0/FactorK_48/Espesor_0.060/12-6010-04-(16ga ANSI-61) - K48 - V11-R0.DXF
src/Proyectos/12-6010-04/Rev_R0/FactorK_48/Espesor_0.060/12-6010-04-(16ga ANSI-61) - K48 - V11-R0.SLDDRW
src/Proyectos/12-6010-04/Rev_R0/FactorK_48/Espesor_0.060/12-6010-04-(16ga ANSI-61) - K48 - V11-R0.sldprt
src/Proyectos/12-6010-09/Rev_R0/FactorK_48/Espesor_0.060/12-6010-09-(16gacr ANSI-61) - K48 - V11-R0.DXF
src/Proyectos/12-6010-09/Rev_R0/FactorK_48/Espesor_0.060/12-6010-09-(16gacr ANSI-61) - K48 - V11-R0.SLDDRW
src/Proyectos/12-6010-09/Rev_R0/FactorK_48/Espesor_0.060/12-6010-09-(16gacr ANSI-61) - K48 - V11-R0.SLDPRT
src/Proyectos/12-6113-05/Rev_R2/FactorK_47/Espesor_0.105/12-6113-05-(12gacr ANSI-61) - K47 - V13-R2.DXF
src/Proyectos/12-6113-05/Rev_R2/FactorK_47/Espesor_0.105/12-6113-05-(12gacr ANSI-61) - K47 - V13-R2.SLDDRW
src/Proyectos/12-6113-05/Rev_R2/FactorK_47/Espesor_0.105/12-6113-05-(12gacr ANSI-61) - K47 - V13-R2.SLDPRT
src/Proyectos/12-6355-02/Rev_R0/FactorK_48/Espesor_0.060/12-6355-02-(16ga ANSI-61) - K48 - V2-R0.DXF
src/Proyectos/12-6355-02/Rev_R0/FactorK_48/Espesor_0.060/12-6355-02-(16ga ANSI-61) - K48 - V2-R0.SLDDRW
src/Proyectos/12-6355-02/Rev_R0/FactorK_48/Espesor_0.060/12-6355-02-(16ga ANSI-61) - K48 - V2-R0.SLDPRT
src/Proyectos/12-6355-03/Rev_R0/FactorK_48/Espesor_0.060/12-6355-03-(16gacr ANSI-61) - K48 - V2-R0.DXF
src/Proyectos/12-6355-03/Rev_R0/FactorK_48/Espesor_0.060/12-6355-03-(16gacr ANSI-61) - K48 - V2-R0.SLDDRW
src/Proyectos/12-6355-03/Rev_R0/FactorK_48/Espesor_0.060/12-6355-03-(16gacr ANSI-61) - K48 - V2-R0.SLDPRT
src/Proyectos/12-A-6199-01/Rev_R0/FactorK_48/Espesor_0.105/12-A-6199-01-(12gacr ANSI-61) - K48 - V3-R0.DXF
src/Proyectos/12-A-6199-01/Rev_R0/FactorK_48/Espesor_0.105/12-A-6199-01-(12gacr ANSI-61) - K48 - V3-R0.SLDDRW
src/Proyectos/12-A-6199-01/Rev_R0/FactorK_48/Espesor_0.105/12-A-6199-01-(12gacr ANSI-61) - K48 - V3-R0.SLDPRT
src/Proyectos/12-A-6199-02/Rev_R2/FactorK_47/Espesor_0.105/12-A-6199-02-(12gacr ANSI-61) - K47 - V3-R2.DXF
src/Proyectos/12-A-6199-02/Rev_R2/FactorK_47/Espesor_0.105/12-A-6199-02-(12gacr ANSI-61) - K47 - V3-R2.SLDDRW
src/Proyectos/12-A-6199-02/Rev_R2/FactorK_47/Espesor_0.105/12-A-6199-02-(12gacr ANSI-61) - K47 - V3-R2.SLDPRT
src/Proyectos/12-A-6200-02/Rev_R2/FactorK_47/Espesor_0.105/12-A-6200-02-(12gacr ANSI-61) - K47 - V4-R2.DXF
src/Proyectos/12-A-6200-02/Rev_R2/FactorK_47/Espesor_0.105/12-A-6200-02-(12gacr ANSI-61) - K47 - V4-R2.SLDDRW
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
