jesusalbertomoraleslopez-byte/control-dimensional-calidad/(commit log)

2026-06-26 Initial commit - Sistema de Control de Calidad con visualizador 3D
    [11-B-9016-01-(12gacr ANSI-61) - K30 - V0-R0.DXF, 11-B-9016-01-(12gacr ANSI-61) - K30 - V0-R0.SLDDRW, 11-B-9016-01-(12gacr ANSI-61) - K30 - V0-R0.SLDPRT, 11-B-9016-01-(12gacr ANSI-61) - K30 - V0-R0.STEP, 11-B-9016-01-(12gacr ANSI-61) - K30 - V0-R0.xlsx, 12-A-6199-02-(12gacr ANSI-61) - K47 - V3-R2.DXF, 12-A-6199-02-(12gacr ANSI-61) - K47 - V3-R2.SLDDRW, 12-A-6199-02-(12gacr ANSI-61) - K47 - V3-R2.S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]
2026-06-26 Reduce selectbox font sizes by 30% and fix column dropdown selector heights in CAD viewer
2026-06-27 Fix selectbox vertical text clipping and alignment in CAD viewer
2026-09-09 Add colored Excel audit report generator and download buttons for pending engineering files
2026-09-10 Add Concentradora SSO integration and sync engineering project files
    [11-6463-01-(12gacr ANSI-61) - K61 - V6-R0.DXF, 11-6463-01-(12gacr ANSI-61) - K61 - V6-R0.SLDDRW, 11-6463-01-(12gacr ANSI-61) - K61 - V6-R0.SLDPRT, 11-6463-01-(12gacr ANSI-61) - K61 - V6-R0.STEP, 11-6463-01-(12gacr ANSI-61) - K61 - V6-R0.xlsx, 11-8232-01-(12gacr ANSI-61) - K61 - V4-R0.DXF, 11-8232-01-(12gacr ANSI-61) - K61 - V4-R0.SLDDRW, 11-8232-01-(12gacr ANSI-61) - K61 - V4-R0.SLDPRT]
2026-09-10 Add browse folder button and default official path shortcut to bulk import
2026-09-14 revert: restaurar banners originales de cada app y corregir footer
2026-09-24 Migrate 1001 drawing files to private Google Cloud Storage bucket sigrama-planos-calidad-2026, untrack Proyectos from Git, and integrate signed URLs and GCS storage service
    [11-6463-01-(12gacr ANSI-61) - K61 - V6-R0.DXF, 11-6463-01-(12gacr ANSI-61) - K61 - V6-R0.SLDDRW, 11-6463-01-(12gacr ANSI-61) - K61 - V6-R0.SLDPRT, 11-6463-01-(12gacr ANSI-61) - K61 - V6-R0.STEP, 11-6463-01-(12gacr ANSI-61) - K61 - V6-R0.xlsx, 11-8232-01-(12gacr ANSI-61) - K61 - V4-R0.DXF, 11-8232-01-(12gacr ANSI-61) - K61 - V4-R0.SLDDRW, 11-8232-01-(12gacr ANSI-61) - K61 - V4-R0.SLDPRT]
2026-09-24 feat: implementar flujo de auditoria de planos y sincronizacion con bucket GCS
    - Ingesta de 206 piezas (ING0001 a ING0267) desde ruta de red oficial a Bucket GCS
    - Registro con estatus 'Sin Auditar' y consecutivo oficial de ingenieria
    - Restriccion estricta en 3.1 Visualizador 3D CAD: solo piezas 'Auditadas'
    - Modulo 3.2.1 Auditoria y Validacion de Planos con checklist documental, visor PDF y aprobacion del Administrador
    - Soporte de semillas automaticas y carga transparente desde GCS
2026-09-24 fix: persistencia DB en GCS - los 3D de piezas auditadas ya se visualizan
    CAUSA RAIZ: Streamlit Cloud tiene filesystem efimero - la DB SQLite se borra
    en cada redeploy. Las auditorias que hacia el Administrador se perdian.
    SOLUCION:
    - database.py: _sync_db_from_gcs() descarga la DB de GCS al arrancar si no hay
    DB local o esta vacia (system/sigrama_calidad.db en el bucket)
    - database.py: save_database_to_gcs() sube la DB a GCS despues de cada escritura
    - v3_2_design.py: llama save_database_to_gcs() despues de auditar/rechazar/resetear
    piezas (individual y en lote)
    - DB inicial con 206 piezas ya subida a gs://sigrama-planos-calidad-2026/system/sigrama_calidad.db
2026-09-24 fix: actualizar Three.js r128 a r158 con ES modules - corrige visor 3D en blanco
    CAUSA RAIZ: Las URLs del CDN de jsdelivr para three@0.128.0/examples/js/
    ya no funcionan correctamente. OrbitControls, STLLoader y CSS2DRenderer
    se cargaban como scripts globales legacy que fallaban silenciosamente,
    dejando el canvas del visor 3D en blanco/invisible.
    - Migrar de scripts CDN legacy a ES importmap con three@0.158.0
    - import * as THREE from 'three' (CDN confiable jsdelivr latest)
    - import OrbitControls, STLLoader, CSS2DRenderer, CSS2DObject como
    named imports de 'three/addons/'
    - Corregir API deprecada: outputEncoding -> outputColorSpace (r152+)
    - Corregir API deprecada: physicallyCorr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
2026-09-24 perf: optimizar carga de modelos 3D con cache en sesion y barra de progreso WASM
    - Implementa cache en st.session_state para no volver a descargar el archivo STEP/STL desde GCS en cada interacción de Streamlit
    - Cambia CDN de WASM occt-import-js a jsdelivr (más veloz y con soporte de streaming)
    - Incorpora barra de progreso visual con porcentaje de descarga en el canvas 3D
    - Garantiza cierre de overlay de carga en caso de error con fallback automático a malla representativa
2026-09-28 fix(design): importar components para vista previa PDF en modulo de auditoria
2026-09-28 fix: remover credenciales visibles en login y soportar rutas GCS y NaN en reportes de ingenieria
2026-09-29 feat(hub): implementar Centro de Control principal con visor 3D, opciones de registro y descargas segun wireframe
2026-09-29 fix(hub): incrustar generate_piece_documents_zip directamente en v0_hub para resolver import error en Streamlit Cloud
2026-09-29 fix(navigation): usar redirect_to_page para evitar StreamlitAPIException al modificar widget instanciado
2026-09-29 fix(glossary): blindar importacion de docx y agregar boton volver a pagina principal
2026-09-29 feat(hub): agregar campo de texto interactivo para buscar y escribir piezas
2026-09-29 Mejoras de Visualización Septiembre 2026
2026-09-29 fix(compatibility): resolver SyntaxError en f-strings anidados para Python 3.10/3.11 en Cloud Run
2026-09-29 fix(cad): manejar valores float/NaN en rutas de archivos para evitar TypeError
2026-09-29 feat(sync): agregar aplicacion grafica y lanzador bat para sincronizar prototipos de red Z a Google Cloud
2026-09-29 feat(audit): agregar matriz interactiva de auditoria tecnica y reporte descargable en Excel para Ingenieria
2026-10-01 feat(cad): agregar control gestual interactivo 3D con camara web (MediaPipe Hands)
2026-10-01 fix(cad): corregir decodificacion de video y posicionamiento de HUD de control gestual
2026-10-01 fix(cad): implementar getUserMedia nativo con manejo de bloqueo de camara y animFrame
2026-10-01 feat(cad): agregar selector de camara y priorizar Integrated Camera sobre celular
2026-10-02 docs: agregar diagrama de arquitectura en formato nativo Draw.io
2026-10-02 feat(docs): agregar logos oficiales (SIGRAMA, Google Cloud, GitHub), animacion de flujo y diseño interactivo amigable
2026-10-02 feat(arch): agregar soporte completo de doble red VPC, 2 servicios Cloud Run, VPC Peering y Rol Personalizado IAM para jesus_aml@hotmail.com
2026-10-05 feat(sync): implementar sincronizacion incremental estricta para omitir archivos existentes y evitar costos innecesarios en GCP
2026-10-13 style: contraste estandar de campos de entrada (fondo blanco, borde oscuro, escritorio gris)
2026-11-03 feat(cad): agregar buscador estilo VS Code con autocompletado y lista sobrepuesta
2026-11-03 fix(cad): garantizar descarga y visualizacion de Plano PDF y STEP en HUD 3D en Cloud Run
2026-11-04 fix(cad): solucionar congelamiento de camara gestual usando THREE.Spherical y bucle 60fps desacoplado
2026-11-04 fix(cad): eliminar regex con escape en highlightMatches que detenia el script 3D
